chennakeshavadasa/PVT-Invariant-Ring-Amplifier/Design Files/README.md

RAMP.zip File contains all the schematics files involved in the design
