chennakeshavadasa/PVT-Invariant-Ring-Amplifier/Thesis/README.md

This work is primarily based on the PhD thesis 'Design Considerations and Circuit Techniques for Robust Ring-Amplifiers' by Praveen Kumar Venkatachala.
