chennakeshavadasa/PVT-Invariant-Ring-Amplifier/Design Files/RAMP/Fully-Diff-RAMP/RAMP-FD.png

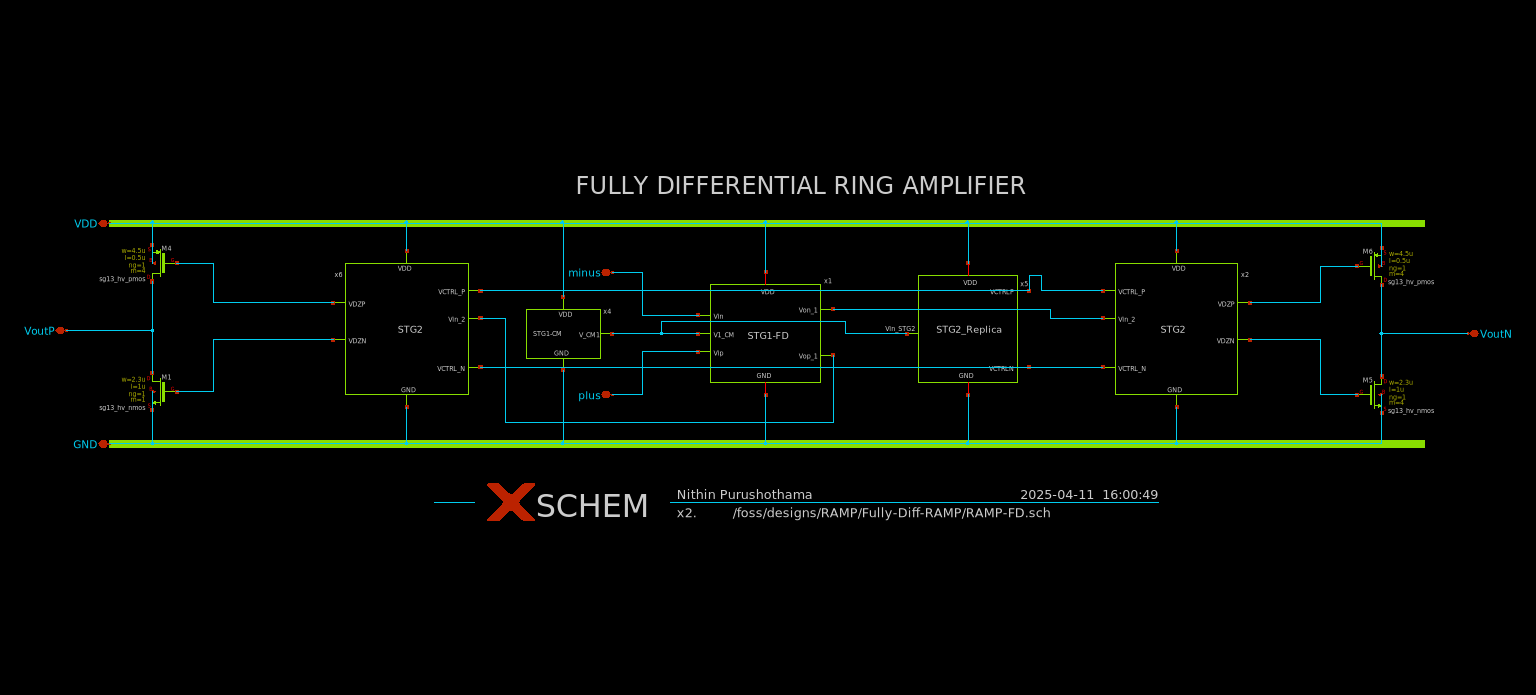
Design Files/RAMP/Fully-Diff-RAMP/RAMP-FD.png
