chennakeshavadasa/PVT-Invariant-Ring-Amplifier/Design Files/RAMP/Fully-Diff-RAMP/RAMP.png

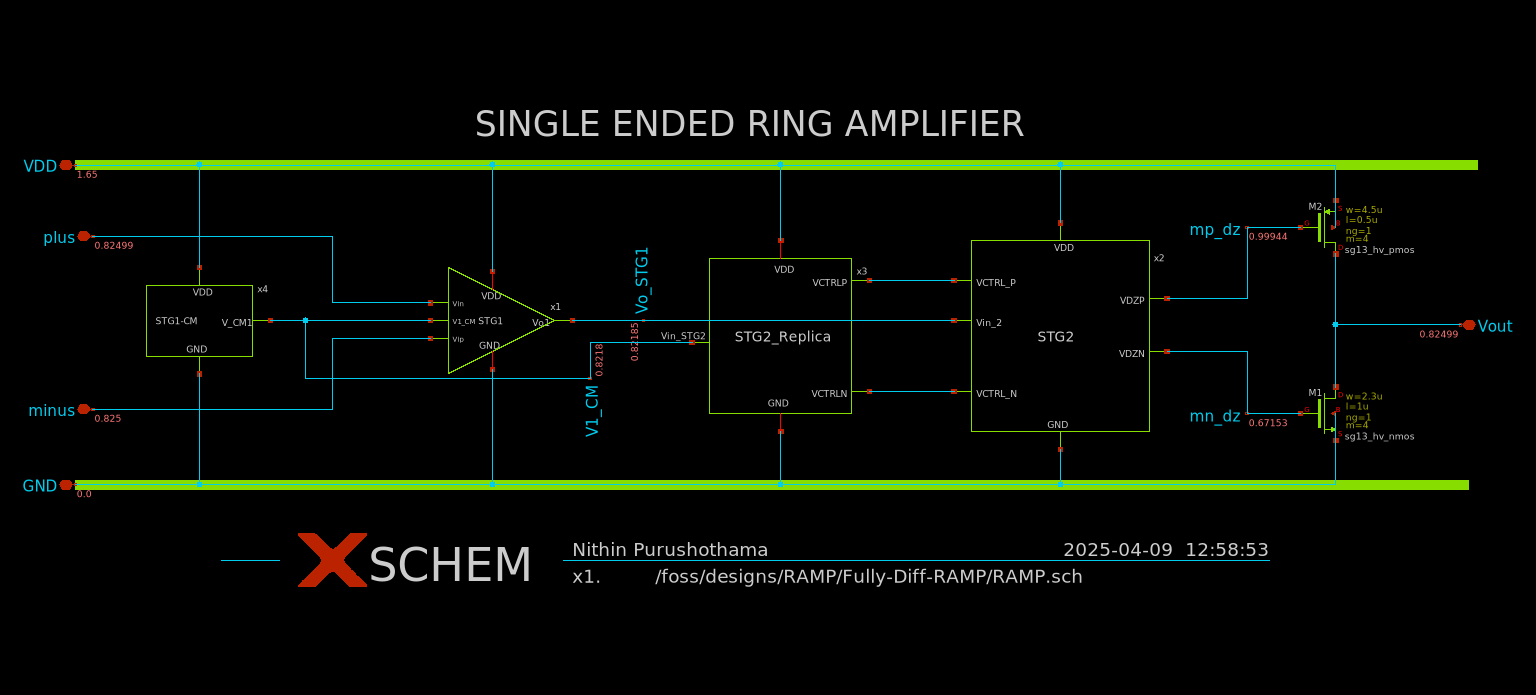
Design Files/RAMP/Fully-Diff-RAMP/RAMP.png
