chennakeshavadasa/PVT-Invariant-Ring-Amplifier/Design Files/RAMP/Fully-Diff-RAMP/STG1-CM.png

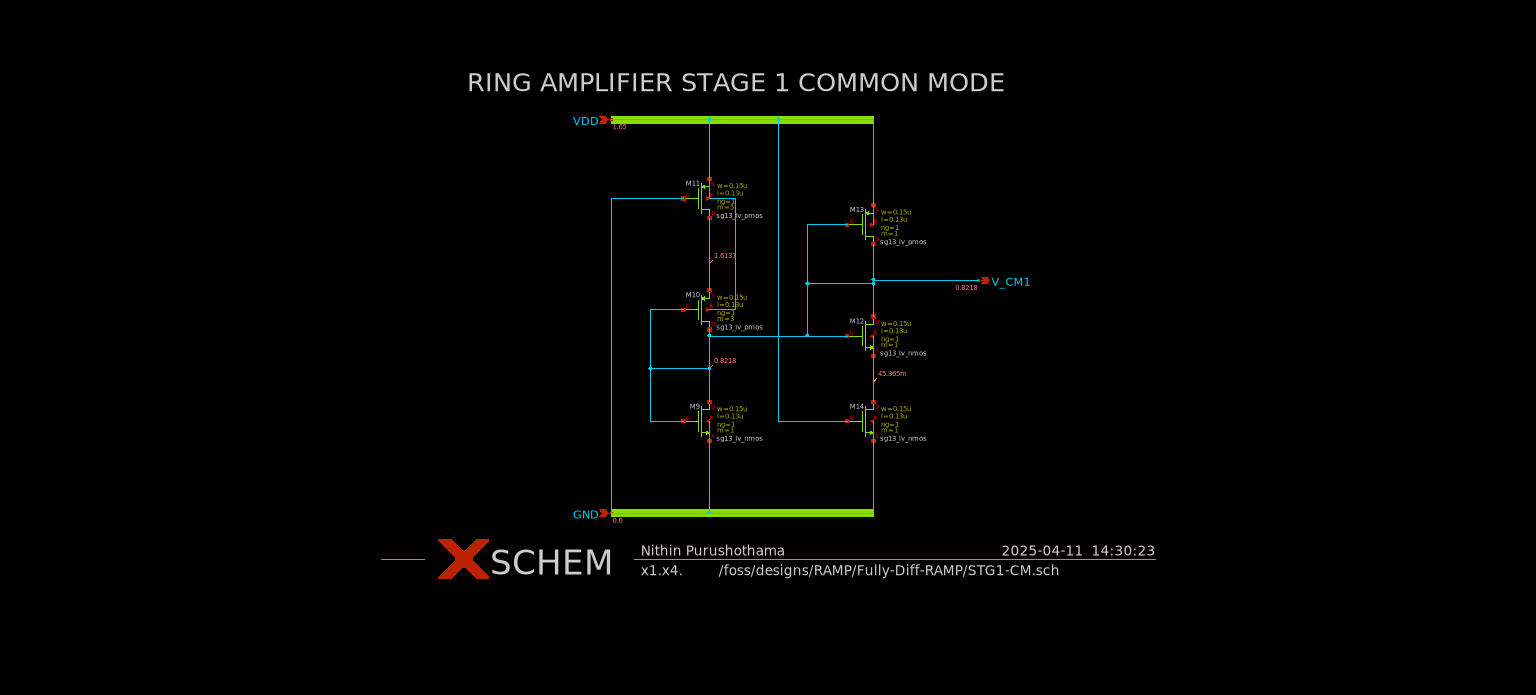
Design Files/RAMP/Fully-Diff-RAMP/STG1-CM.png
