chennakeshavadasa/PVT-Invariant-Ring-Amplifier/Design Files/RAMP/Fully-Diff-RAMP/STG1.png

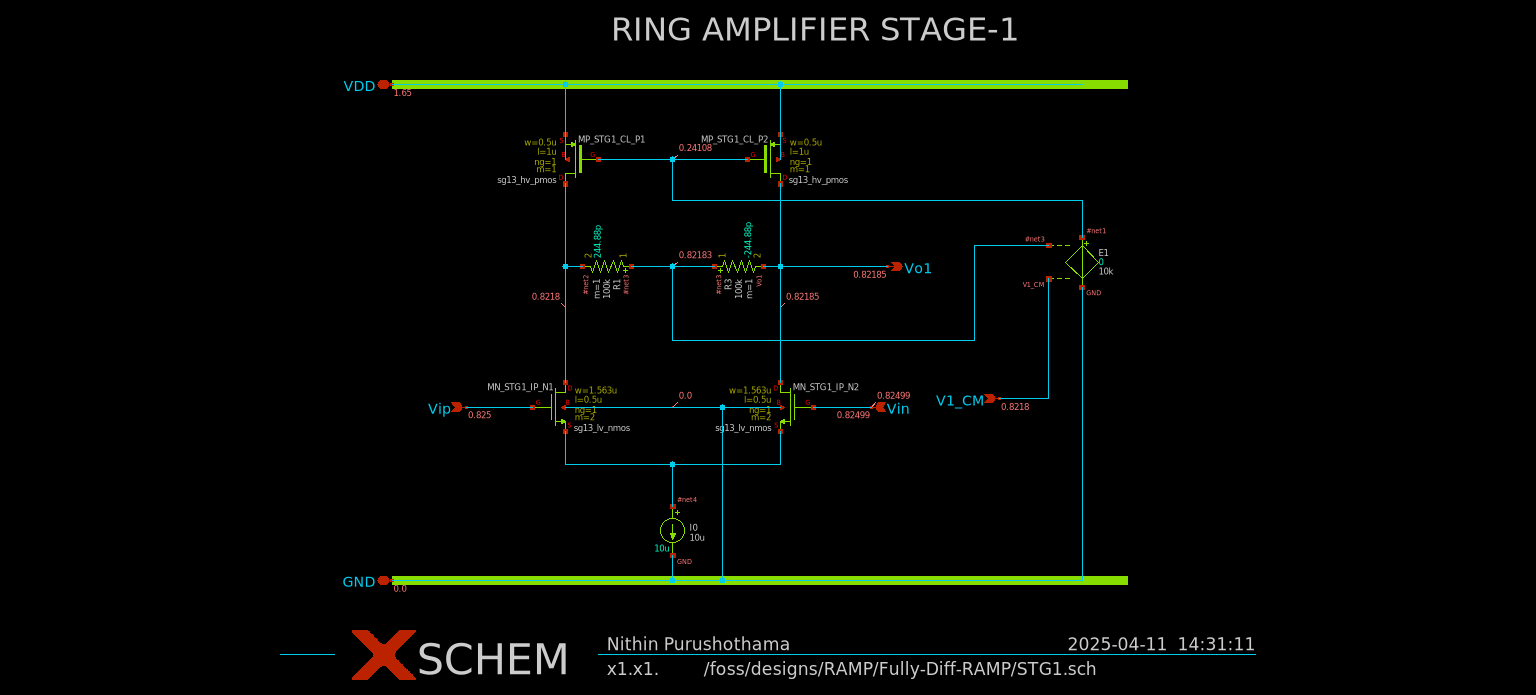
Design Files/RAMP/Fully-Diff-RAMP/STG1.png
