chennakeshavadasa/PVT-Invariant-Ring-Amplifier/Design Files/RAMP/Fully-Diff-RAMP/STG2.png

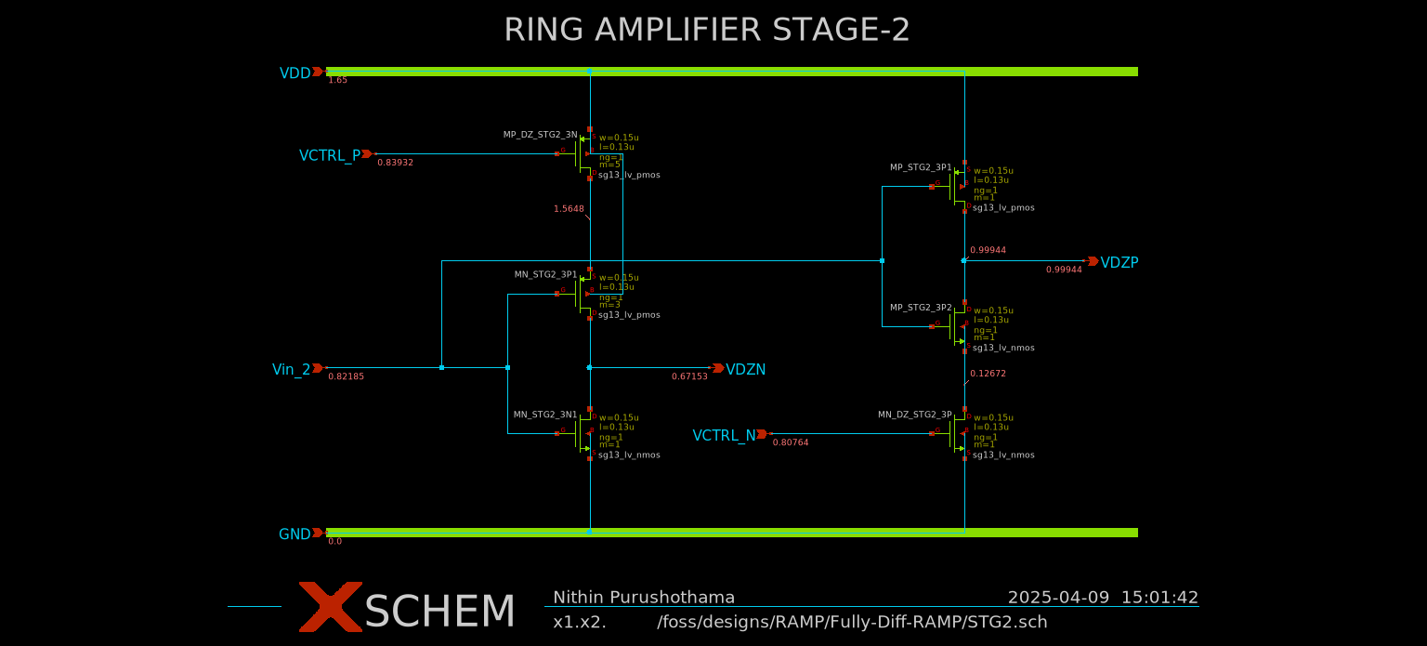
Design Files/RAMP/Fully-Diff-RAMP/STG2.png
