chennakeshavadasa/PVT-Invariant-Ring-Amplifier/Design Files/RAMP/Fully-Diff-RAMP/STG2_Replica.png

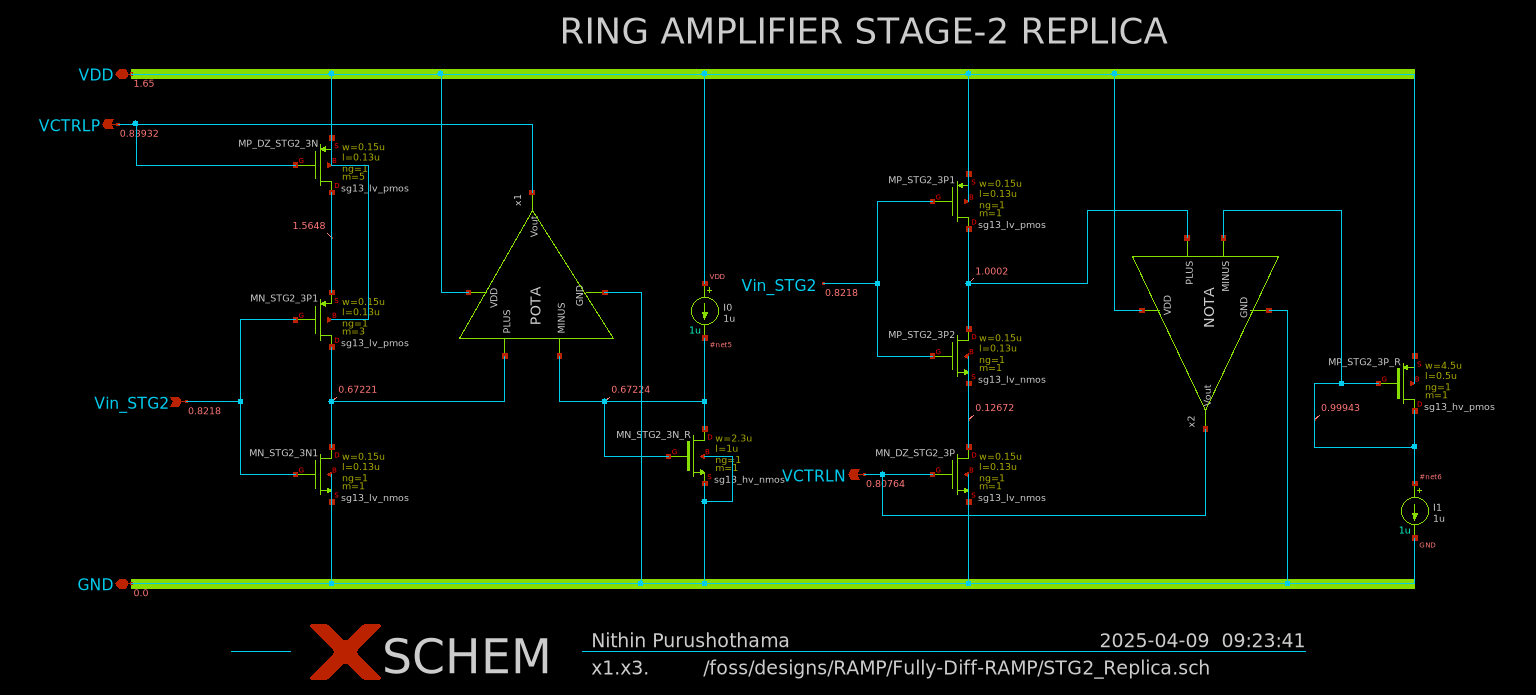
Design Files/RAMP/Fully-Diff-RAMP/STG2_Replica.png
