chennakeshavadasa/PVT-Invariant-Ring-Amplifier/Design Files/RAMP/STG2/DZD_Trk_STG2_try1.png

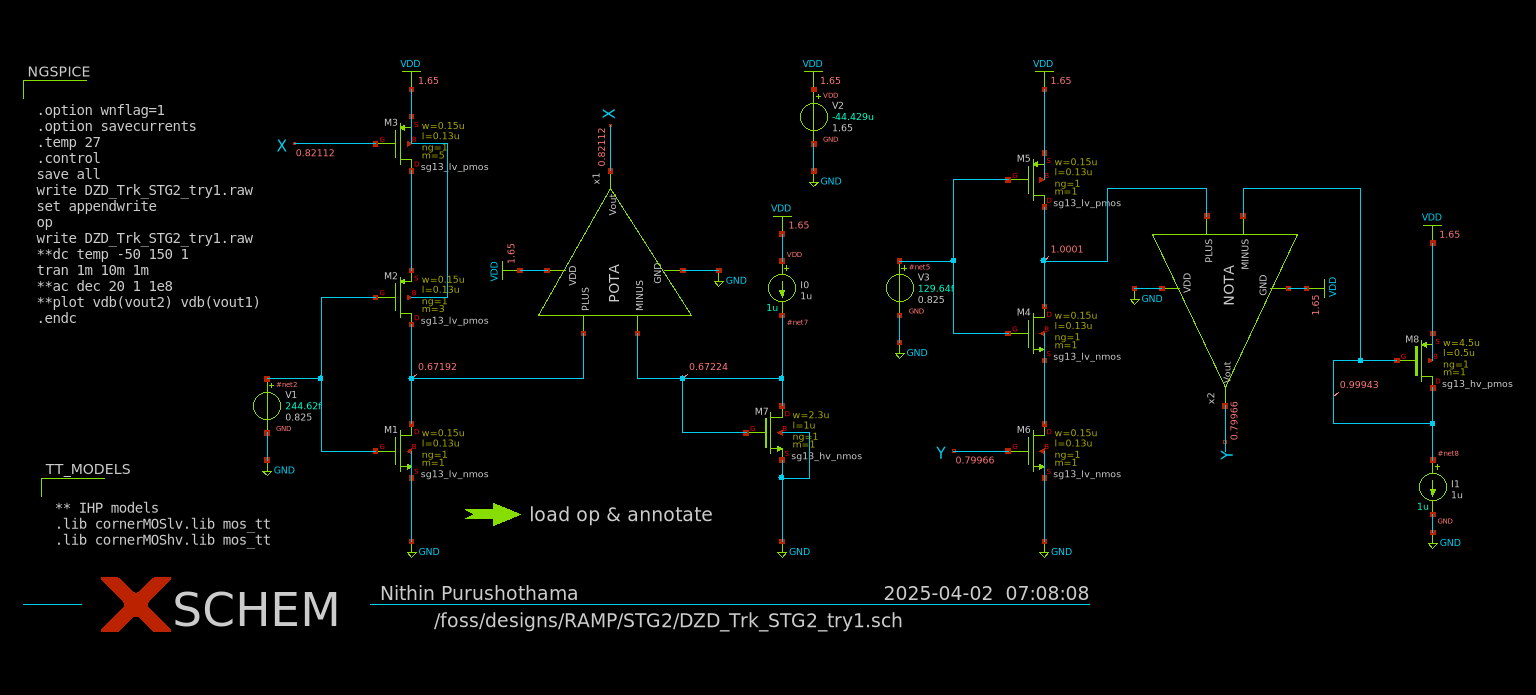
Design Files/RAMP/STG2/DZD_Trk_STG2_try1.png
