chennakeshavadasa/PVT-Invariant-Ring-Amplifier/docs/figures/composites/fig_hero.png

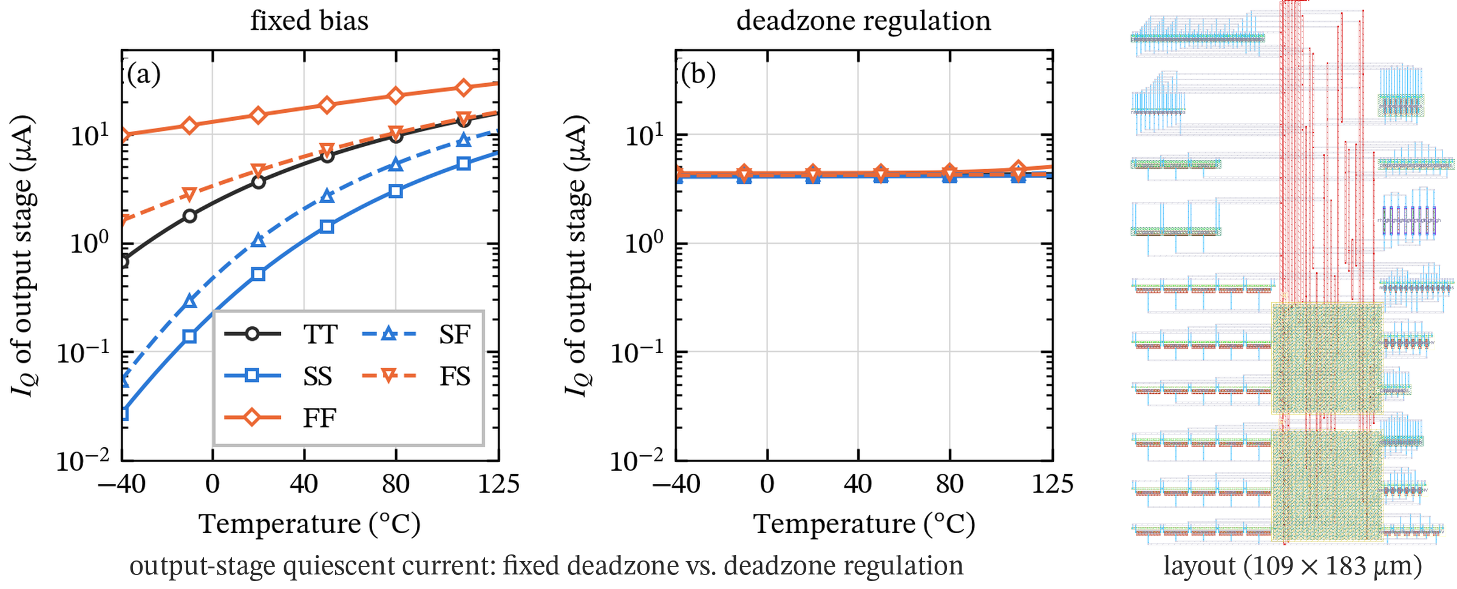
docs/figures/composites/fig_hero.png
