chennakeshavadasa/PVT-Invariant-Ring-Amplifier/docs/figures/diagrams/fig_architecture_v2.png

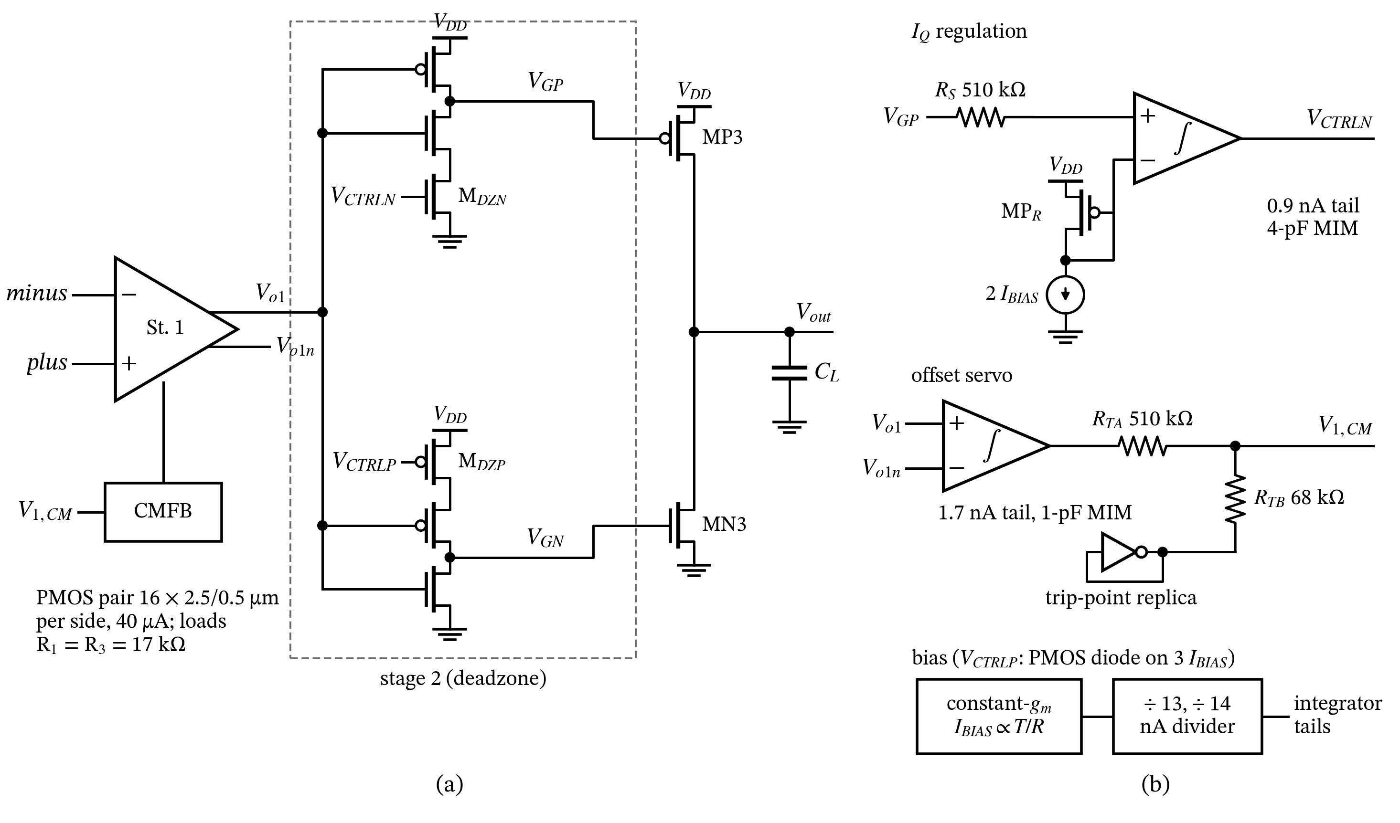
docs/figures/diagrams/fig_architecture_v2.png
