chennakeshavadasa/PVT-Invariant-Ring-Amplifier/docs/figures/layout/fig_layout_plain.png

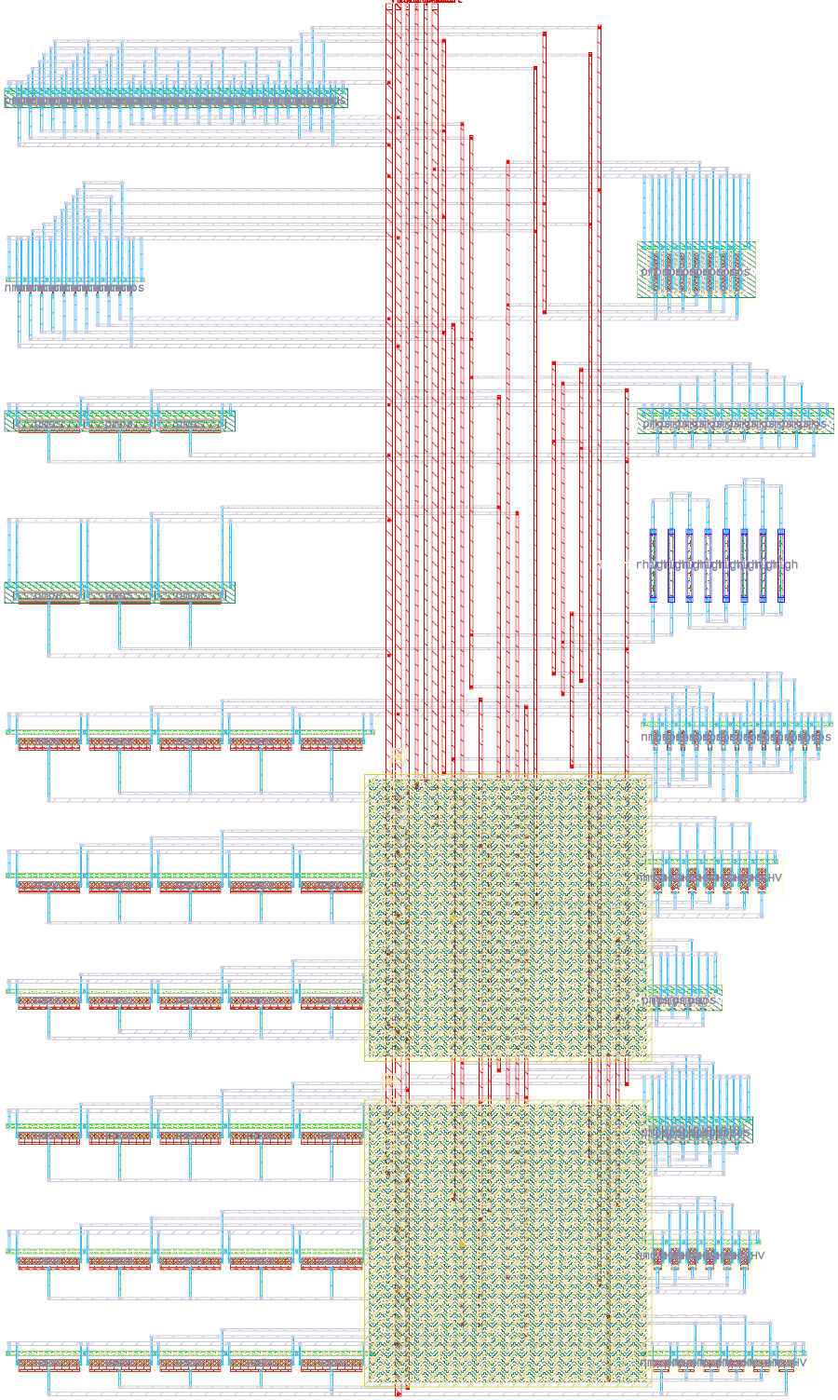
docs/figures/layout/fig_layout_plain.png
