chennakeshavadasa/PVT-Invariant-Ring-Amplifier/docs/figures/layout/fig_layout_v2_full.png

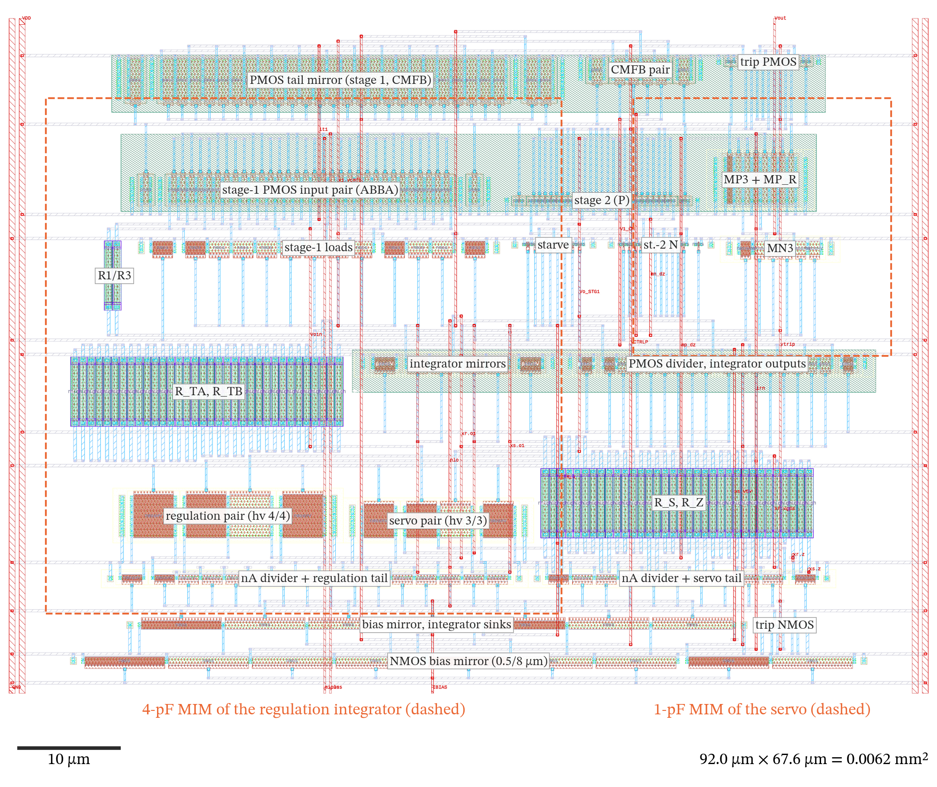
docs/figures/layout/fig_layout_v2_full.png
