chennakeshavadasa/PVT-Invariant-Ring-Amplifier/docs/figures/layout/fig_layout_v2_matching.png

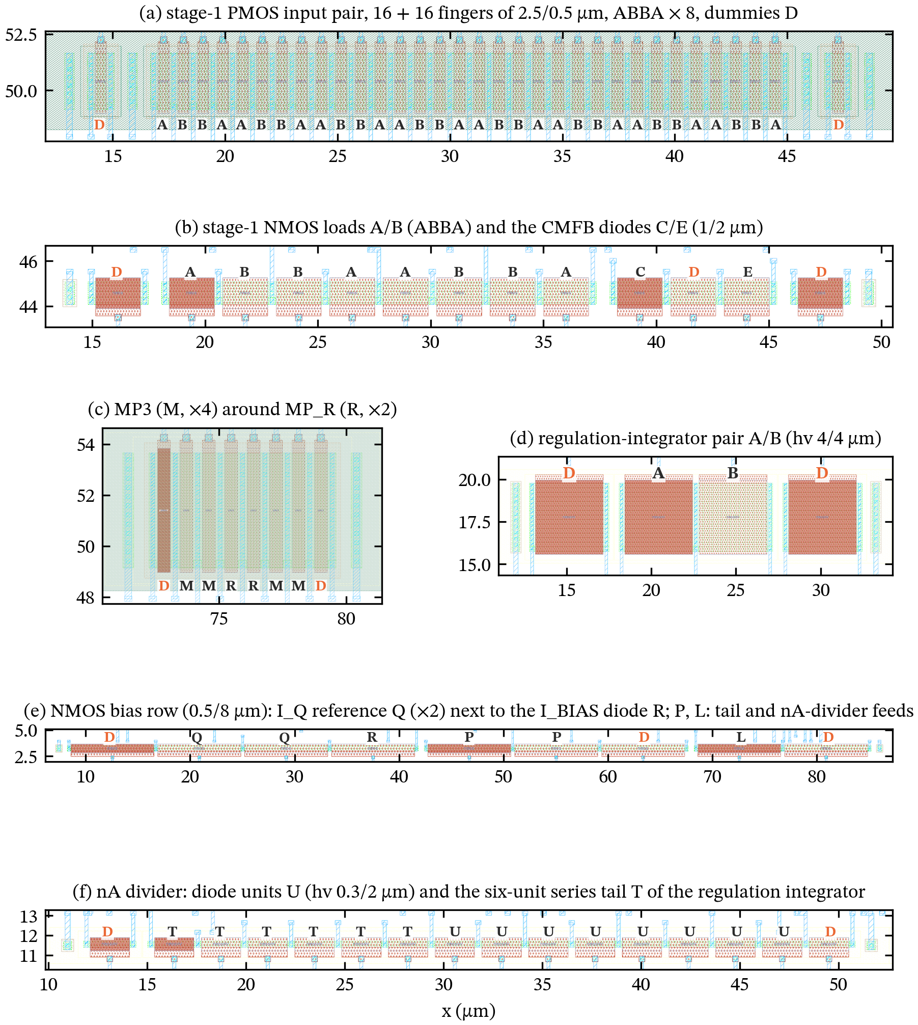
docs/figures/layout/fig_layout_v2_matching.png
