chennakeshavadasa/PVT-Invariant-Ring-Amplifier/docs/figures/schematics/sch_pota.png

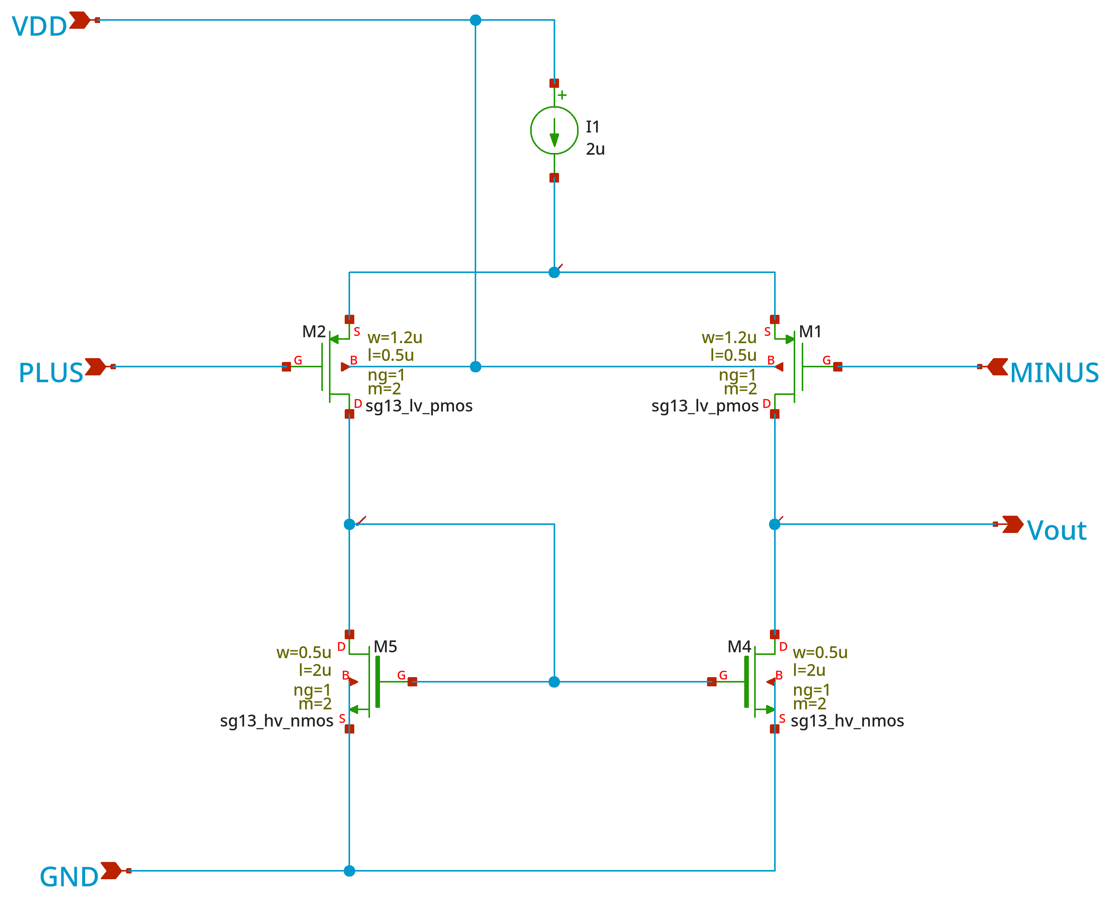
docs/figures/schematics/sch_pota.png
