chennakeshavadasa/PVT-Invariant-Ring-Amplifier/docs/figures/schematics/sch_stg1.png

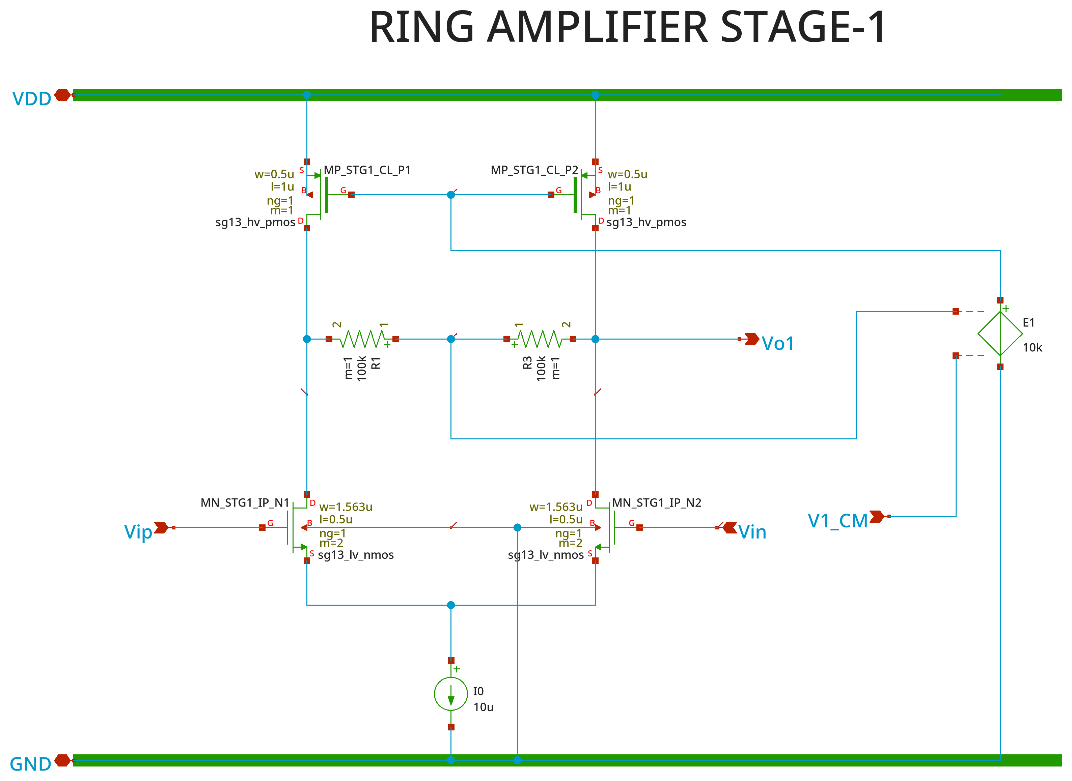
docs/figures/schematics/sch_stg1.png
