chennakeshavadasa/PVT-Invariant-Ring-Amplifier/docs/figures/schematics/sch_stg2.png

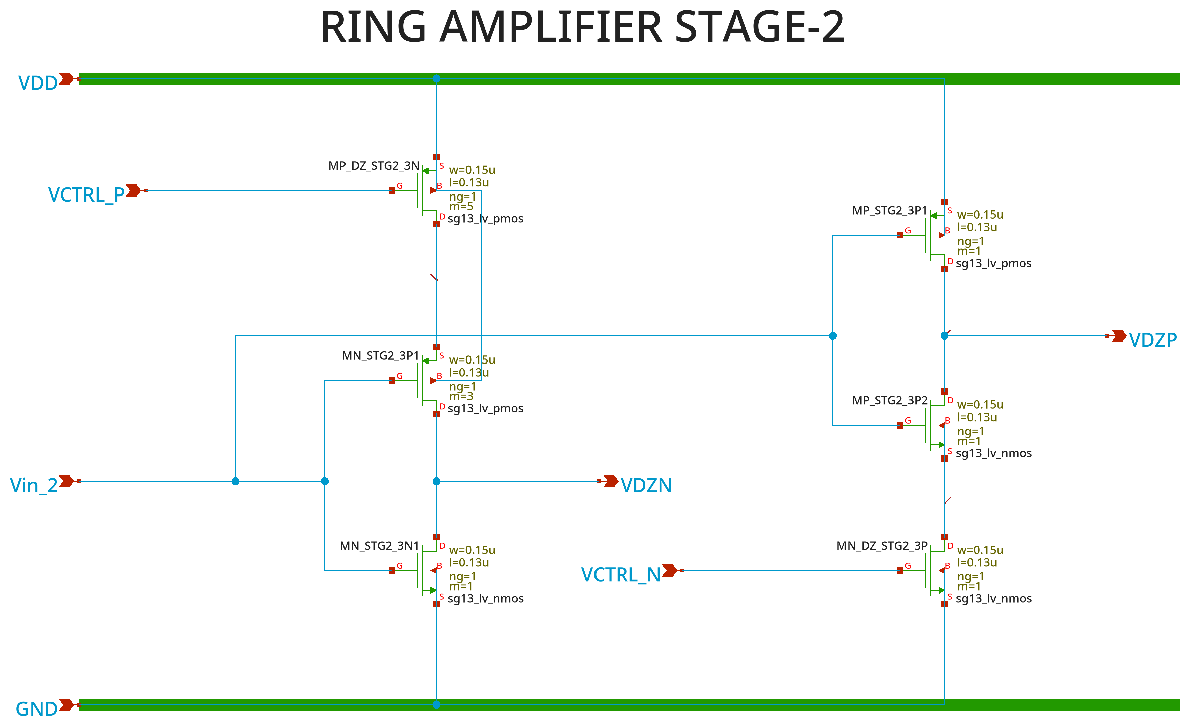
docs/figures/schematics/sch_stg2.png
