chennakeshavadasa/PVT-Invariant-Ring-Amplifier/docs/figures/schematics/sch_stg2_replica.png

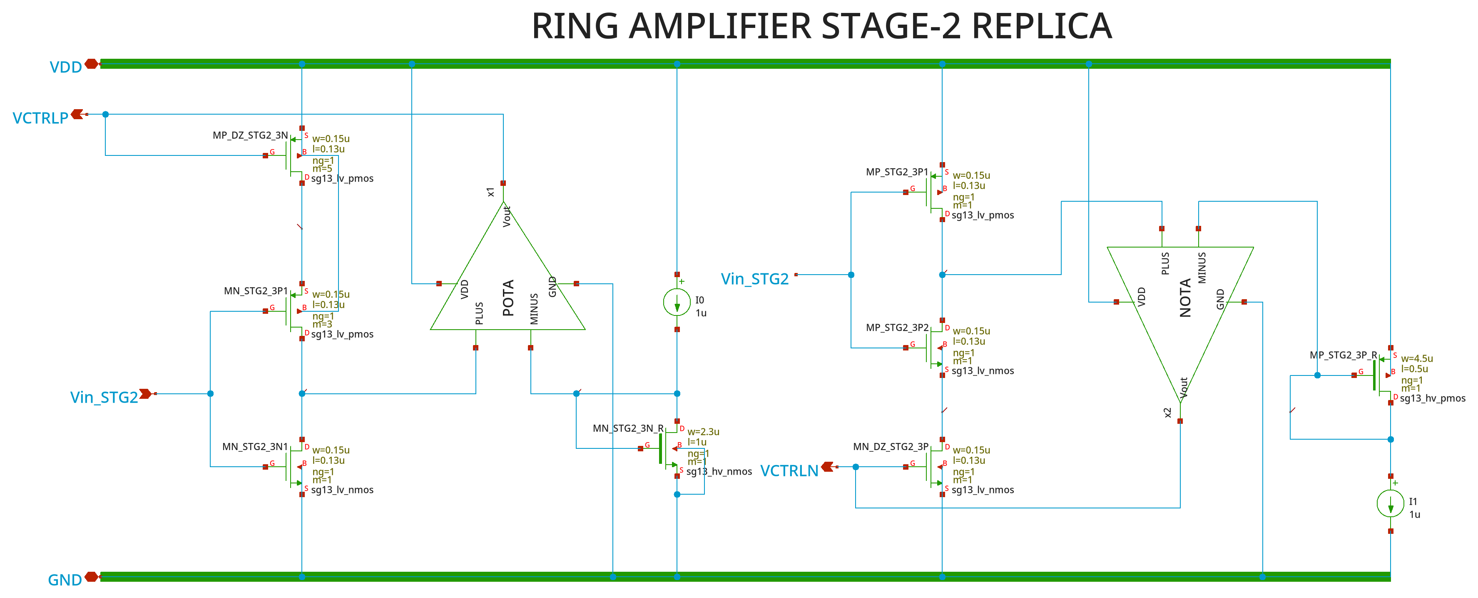
docs/figures/schematics/sch_stg2_replica.png
