chennakeshavadasa/PVT-Invariant-Ring-Amplifier/docs/figures/thesis/fig2_1_sc_amplifier.png

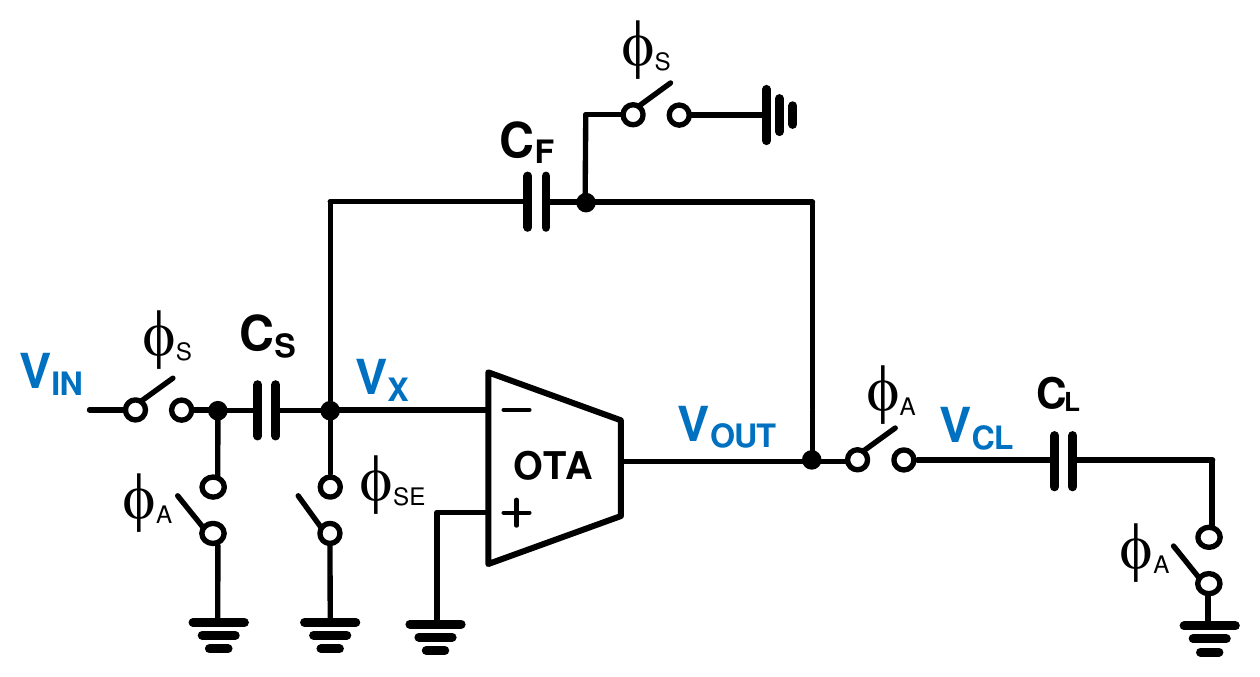
docs/figures/thesis/fig2_1_sc_amplifier.png
