chennakeshavadasa/PVT-Invariant-Ring-Amplifier/docs/figures/thesis/fig2_10_ringamp_iv.png

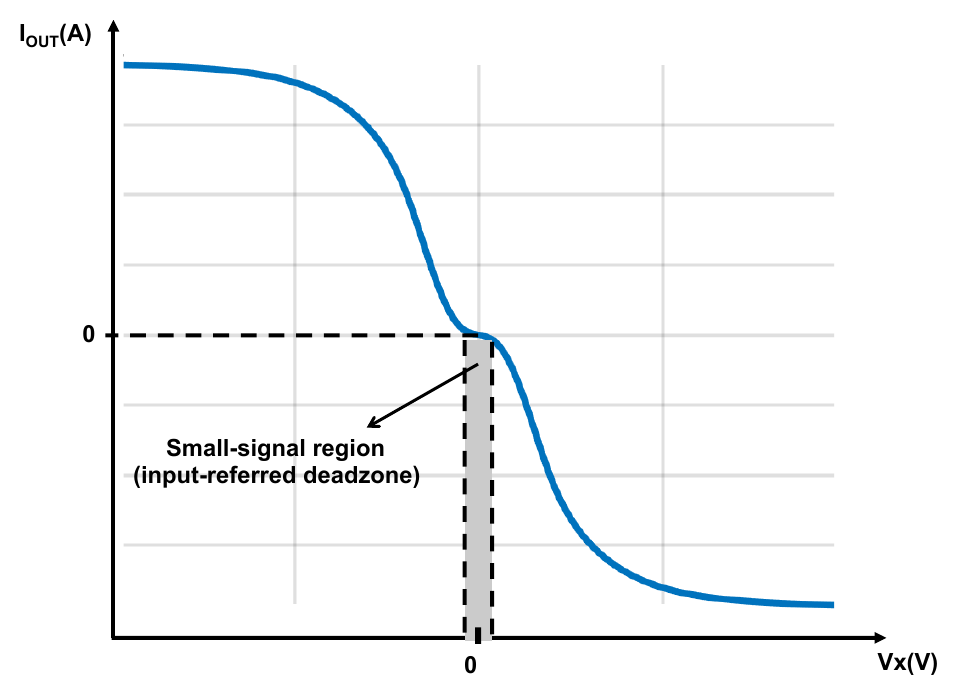
docs/figures/thesis/fig2_10_ringamp_iv.png
