chennakeshavadasa/PVT-Invariant-Ring-Amplifier/docs/figures/thesis/fig2_13_ringamp_overshoot.png

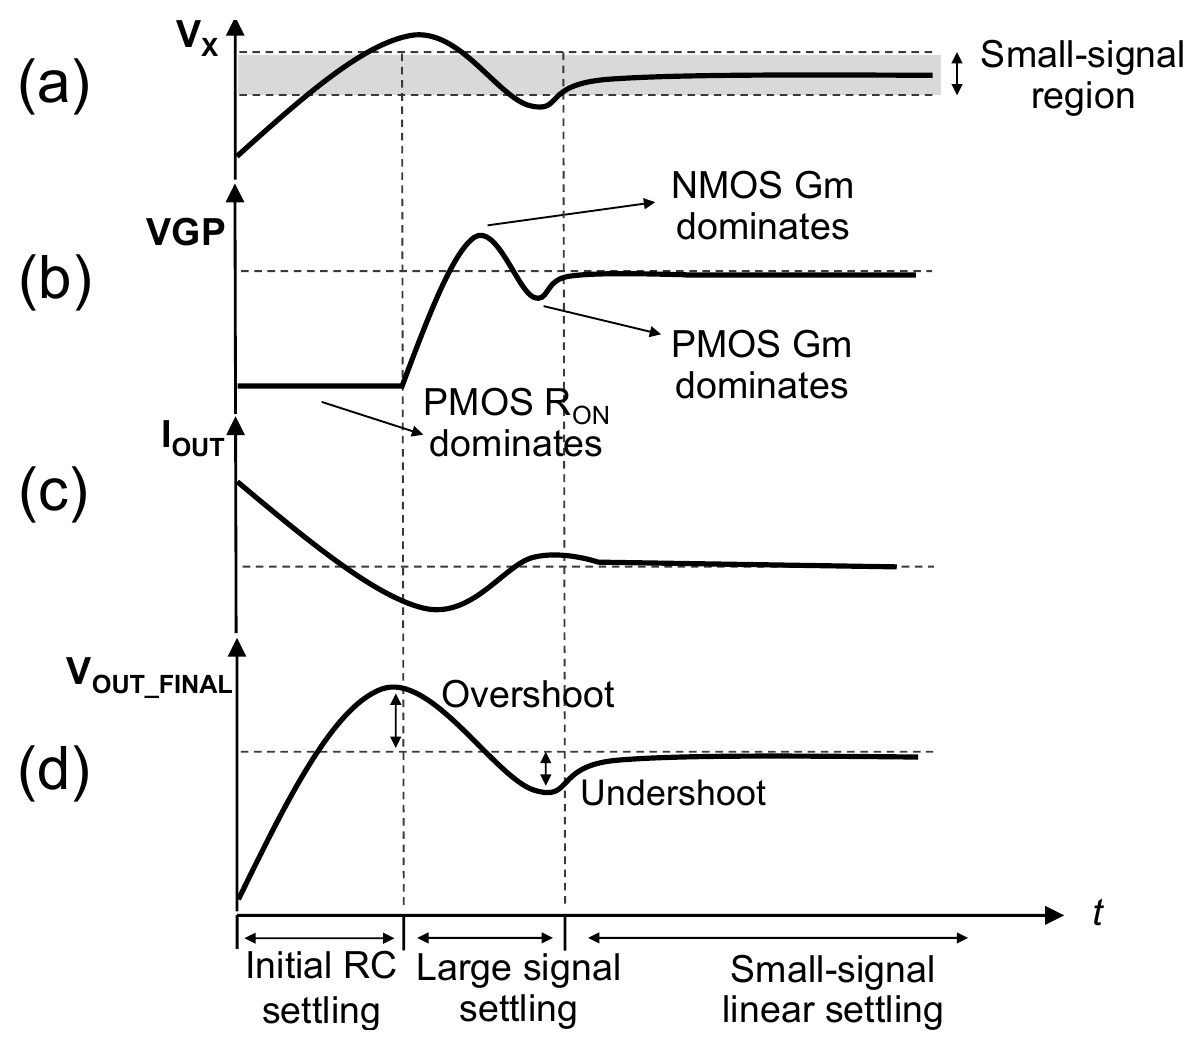
docs/figures/thesis/fig2_13_ringamp_overshoot.png
