chennakeshavadasa/PVT-Invariant-Ring-Amplifier/docs/figures/thesis/fig2_19_rc_model.png

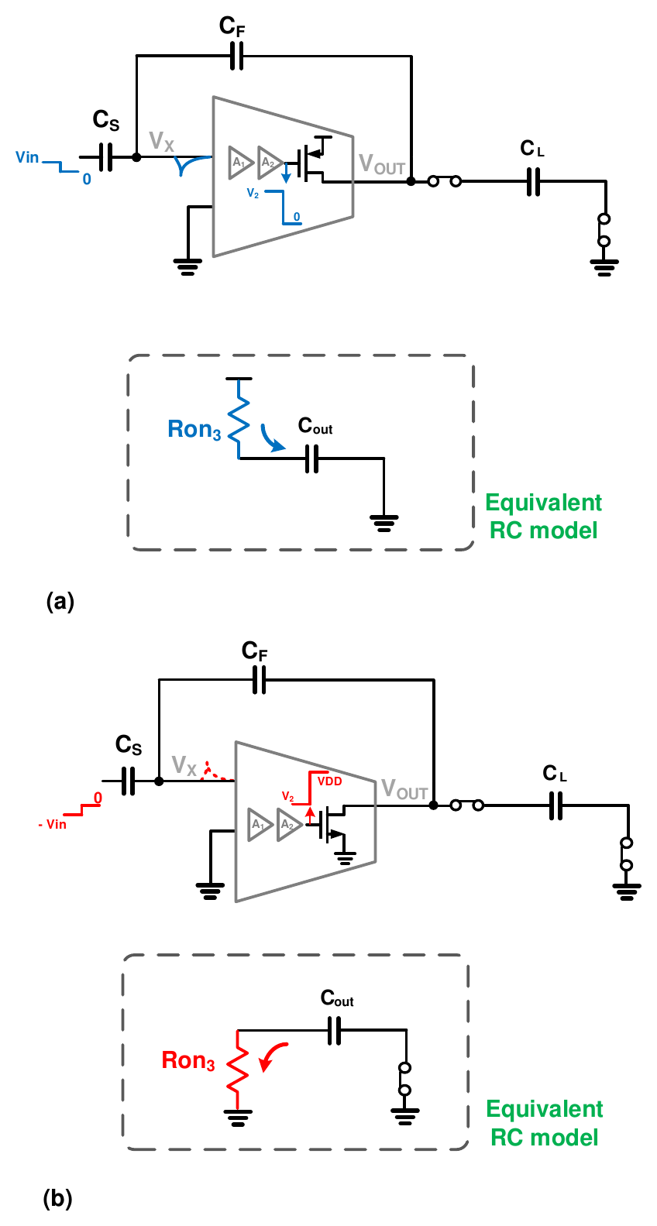
docs/figures/thesis/fig2_19_rc_model.png
