chennakeshavadasa/PVT-Invariant-Ring-Amplifier/docs/figures/thesis/fig2_21_current_starved_ringamp.png

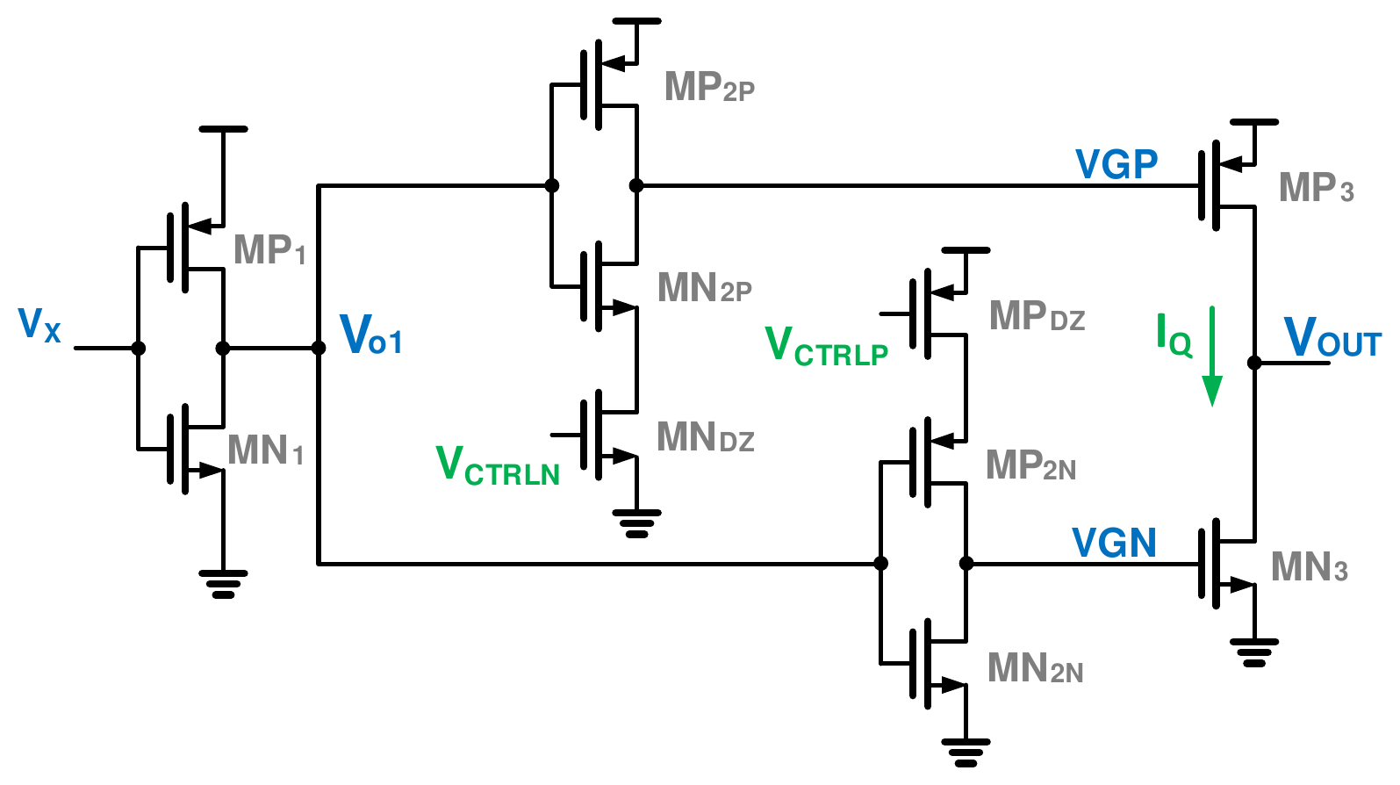
docs/figures/thesis/fig2_21_current_starved_ringamp.png
