chennakeshavadasa/PVT-Invariant-Ring-Amplifier/docs/figures/thesis/fig2_22_settling_example.png

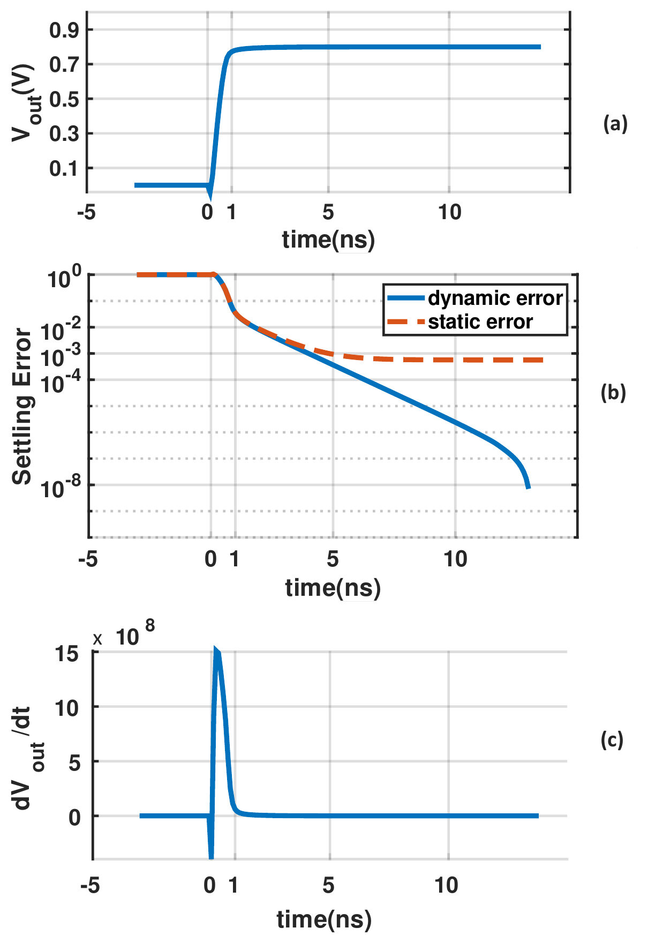
docs/figures/thesis/fig2_22_settling_example.png
