chennakeshavadasa/PVT-Invariant-Ring-Amplifier/docs/figures/thesis/fig3_2_resistor_deadzone.png

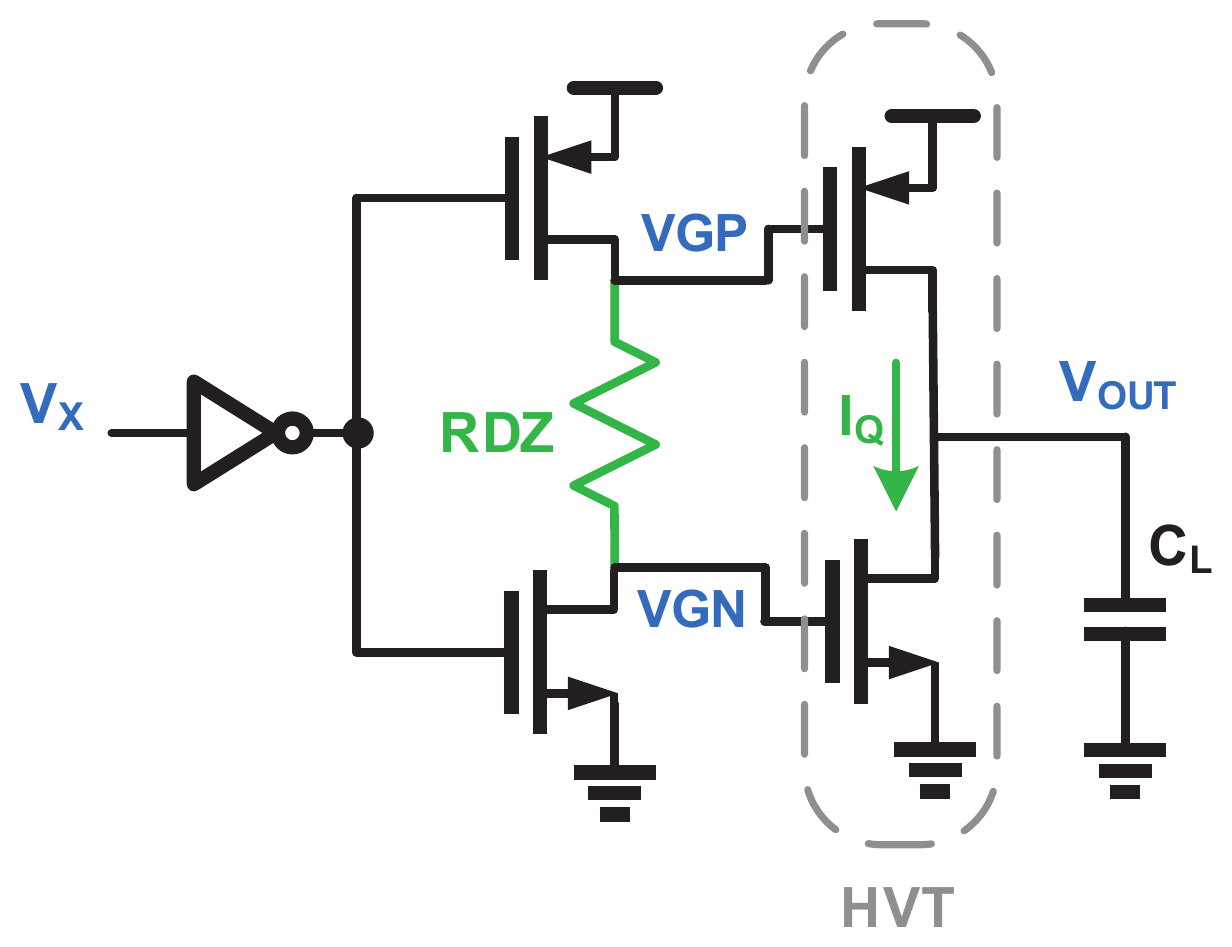
docs/figures/thesis/fig3_2_resistor_deadzone.png
