chennakeshavadasa/PVT-Invariant-Ring-Amplifier/docs/figures/v2/fig_v2_bode_corners.png

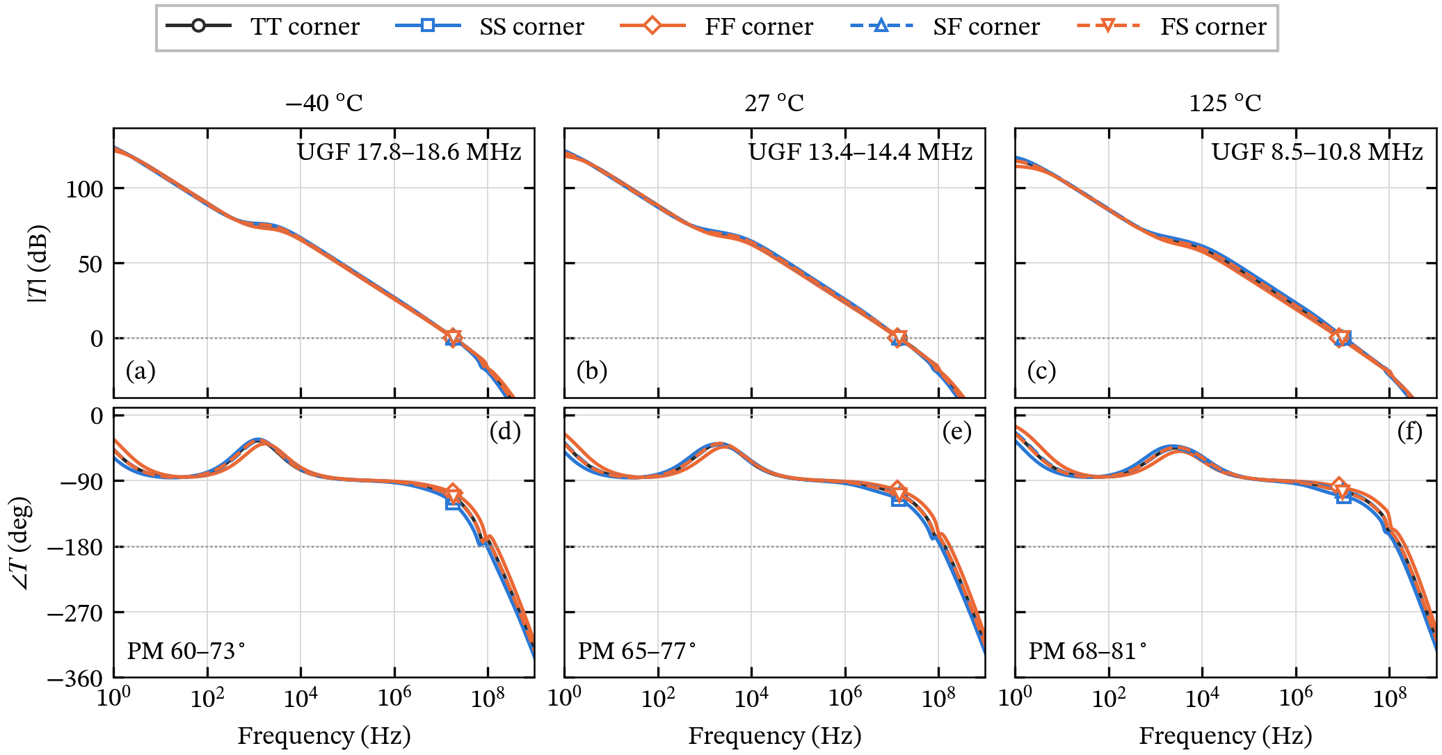
docs/figures/v2/fig_v2_bode_corners.png
