chennakeshavadasa/PVT-Invariant-Ring-Amplifier/docs/figures/v2/fig_v2_iq_temperature.png

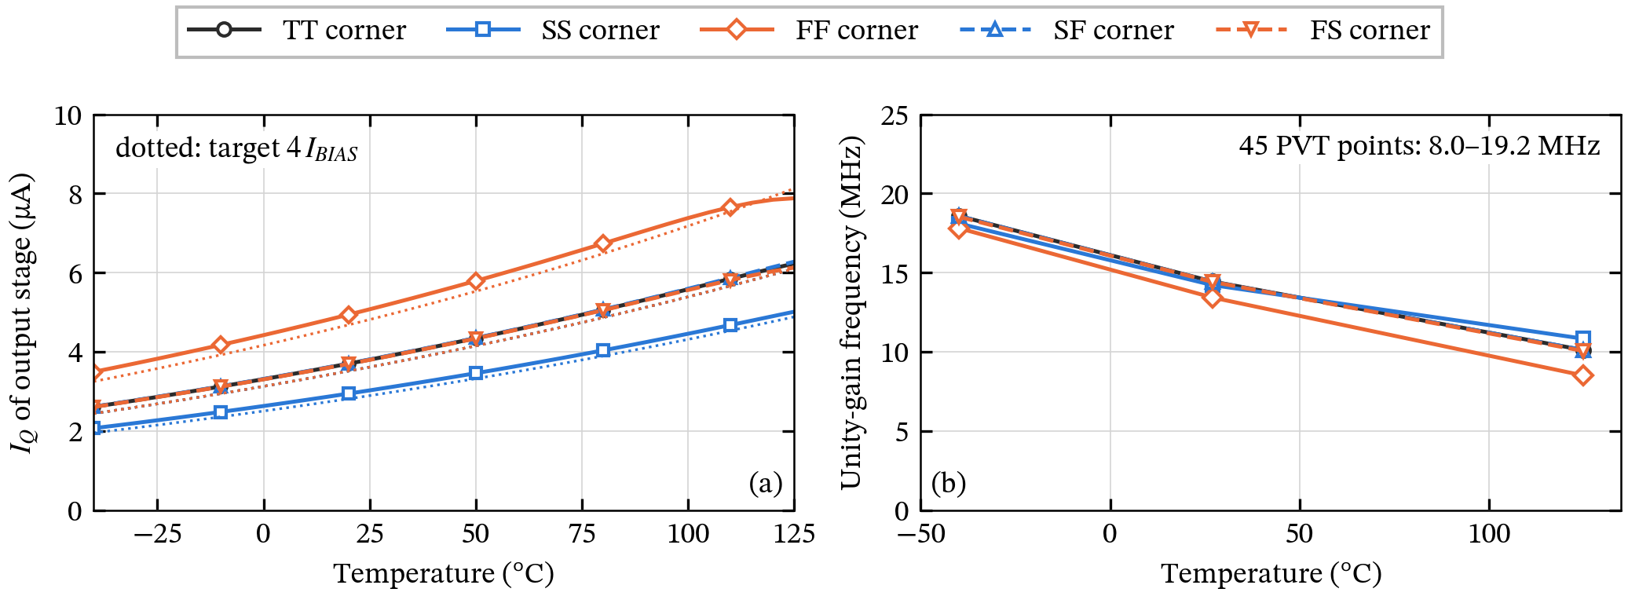
docs/figures/v2/fig_v2_iq_temperature.png
