chennakeshavadasa/PVT-Invariant-Ring-Amplifier/docs/figures/v2/fig_v2_limit_cycle.png

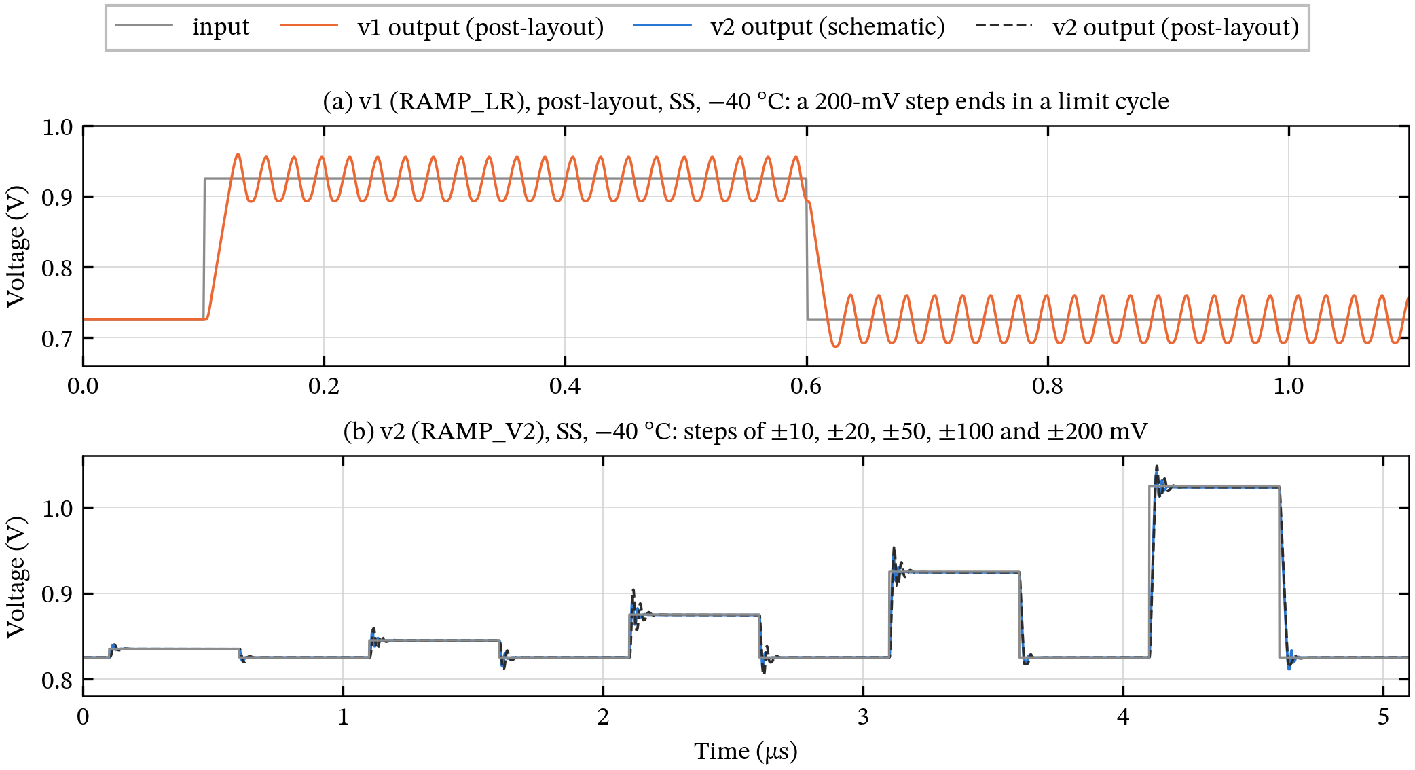
docs/figures/v2/fig_v2_limit_cycle.png
