chennakeshavadasa/PVT-Invariant-Ring-Amplifier/docs/figures/v2/fig_v2_mc_offset_iq.png

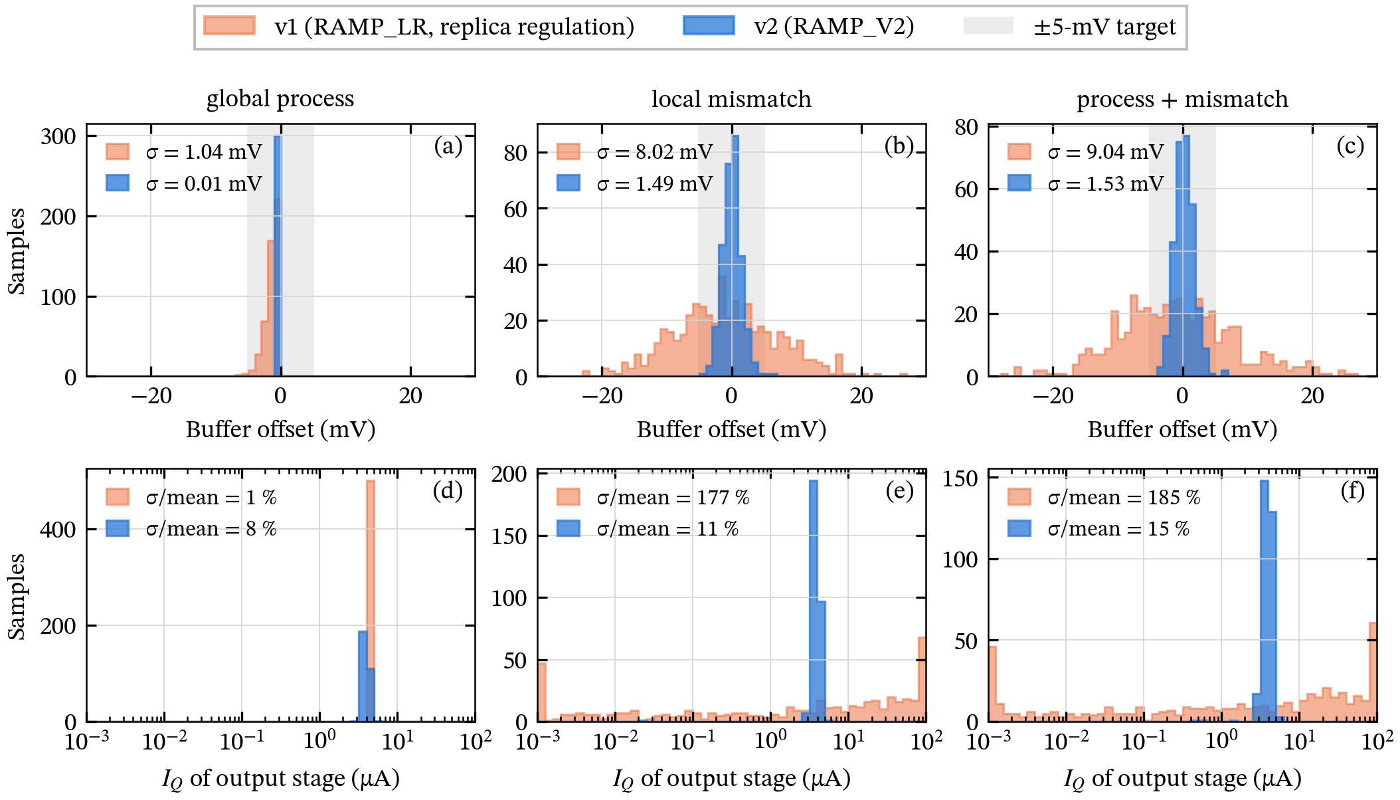
docs/figures/v2/fig_v2_mc_offset_iq.png
