chennakeshavadasa/PVT-Invariant-Ring-Amplifier/docs/figures/v2/fig_v2_mc_perf.png

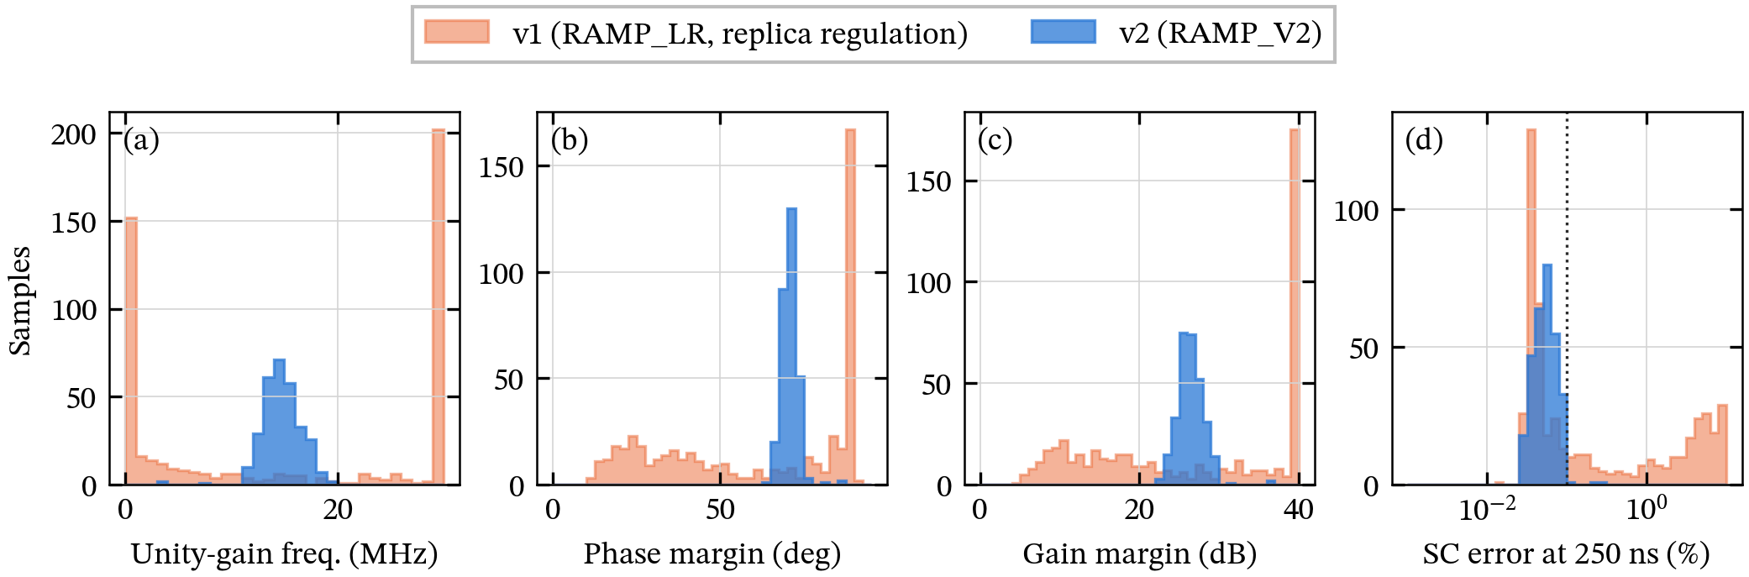
docs/figures/v2/fig_v2_mc_perf.png
