chennakeshavadasa/PVT-Invariant-Ring-Amplifier/docs/figures/v2/fig_v2_mc_waves.png

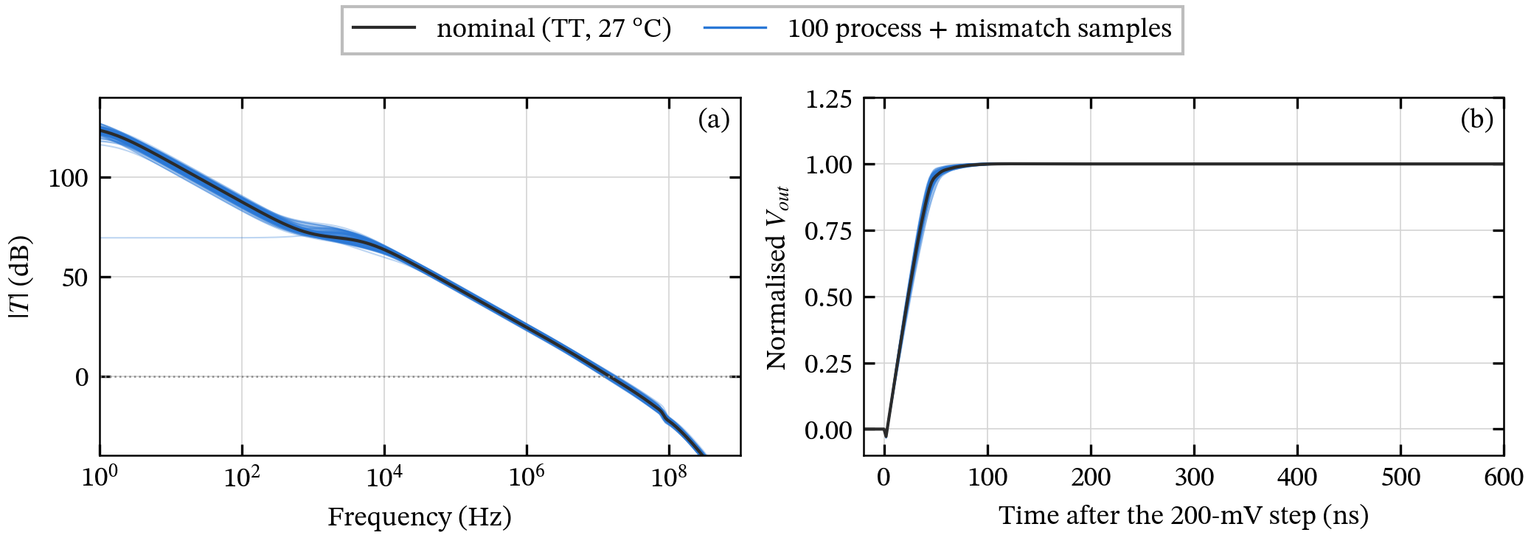
docs/figures/v2/fig_v2_mc_waves.png
