chennakeshavadasa/PVT-Invariant-Ring-Amplifier/docs/figures/v2/fig_v2_power.png

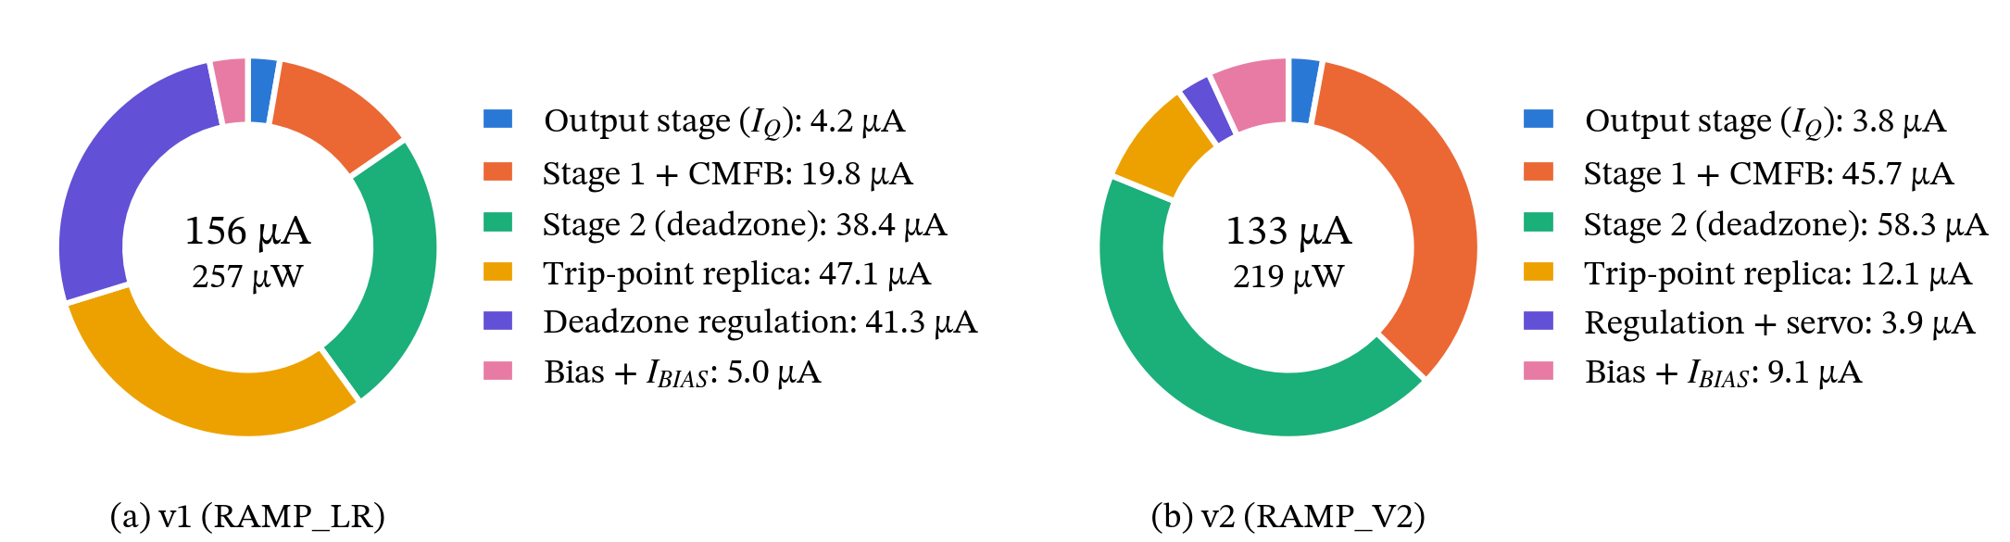
docs/figures/v2/fig_v2_power.png
