chennakeshavadasa/PVT-Invariant-Ring-Amplifier/docs/figures/v2/fig_v2_pvt_ugf_pm.png

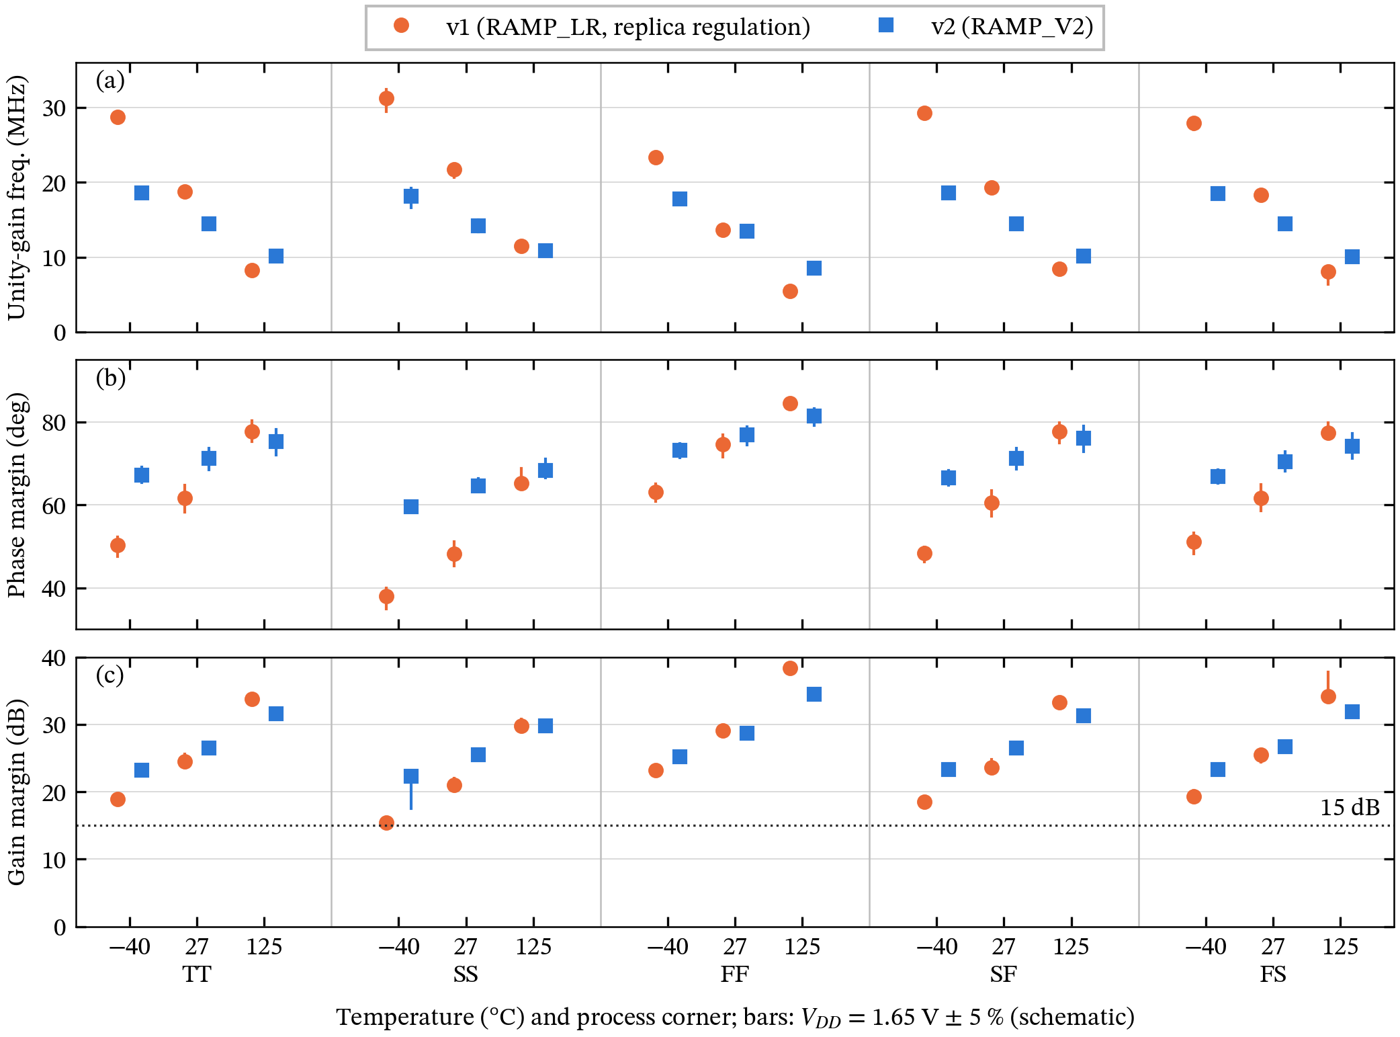
docs/figures/v2/fig_v2_pvt_ugf_pm.png
