chennakeshavadasa/PVT-Invariant-Ring-Amplifier/docs/figures/v2/fig_v2_settling_pvt.png

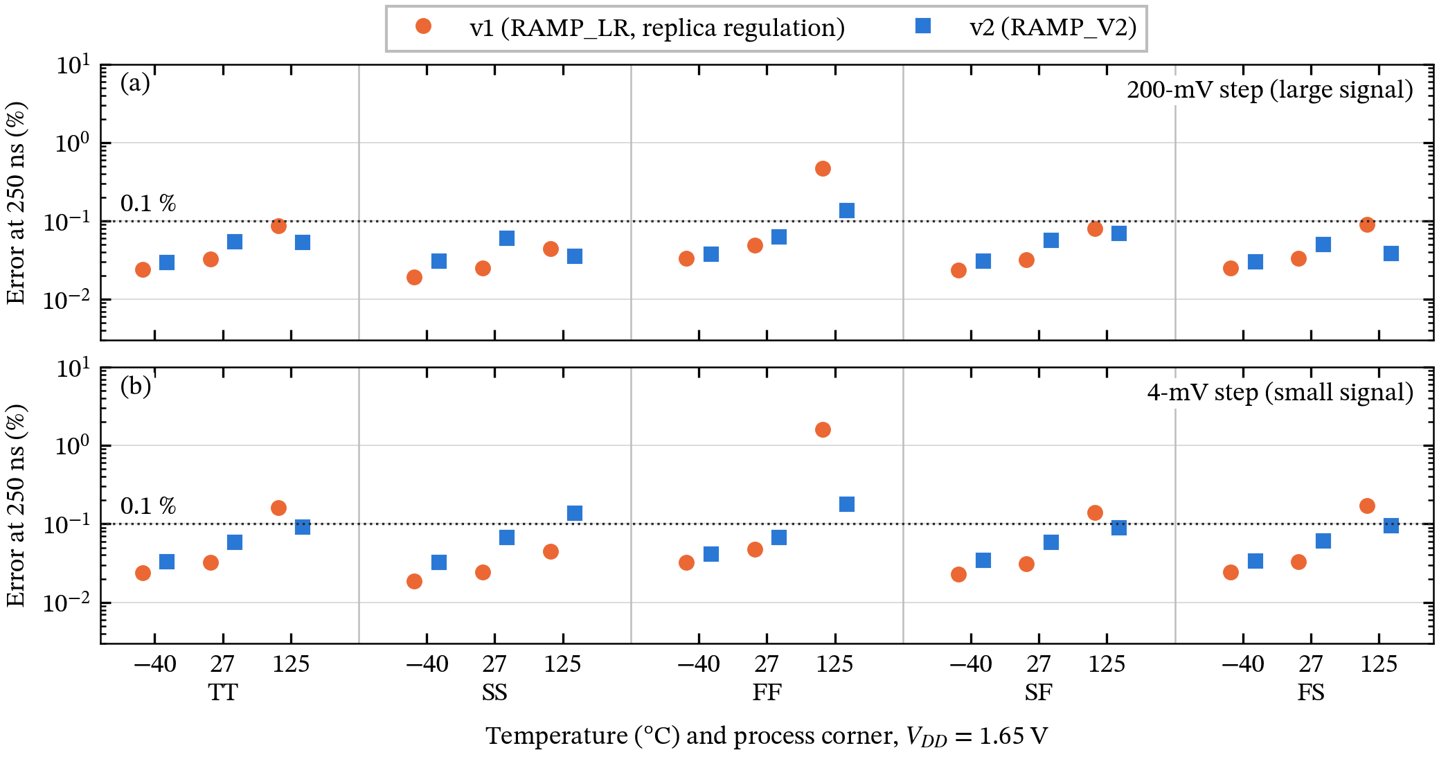
docs/figures/v2/fig_v2_settling_pvt.png
