chennakeshavadasa/PVT-Invariant-Ring-Amplifier/docs/figures/v2/fig_v2_startup.png

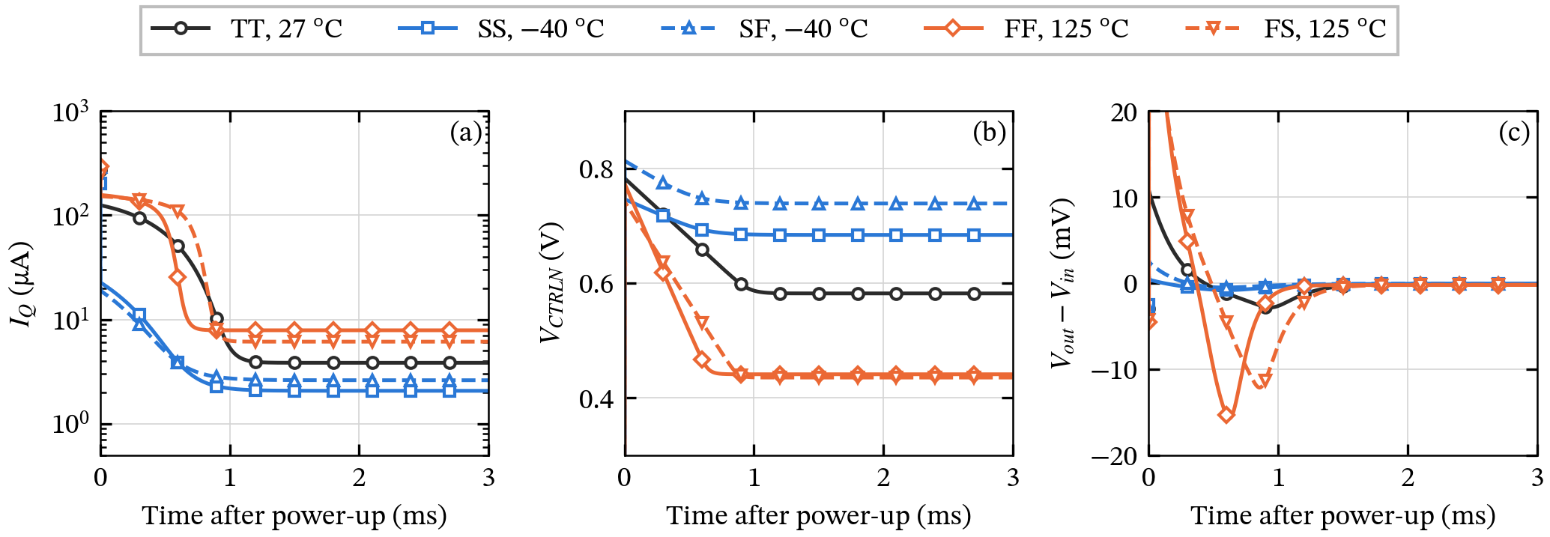
docs/figures/v2/fig_v2_startup.png
