chennakeshavadasa/PVT-Invariant-Ring-Amplifier/docs/figures/v2/fig_v2_tail_study.png

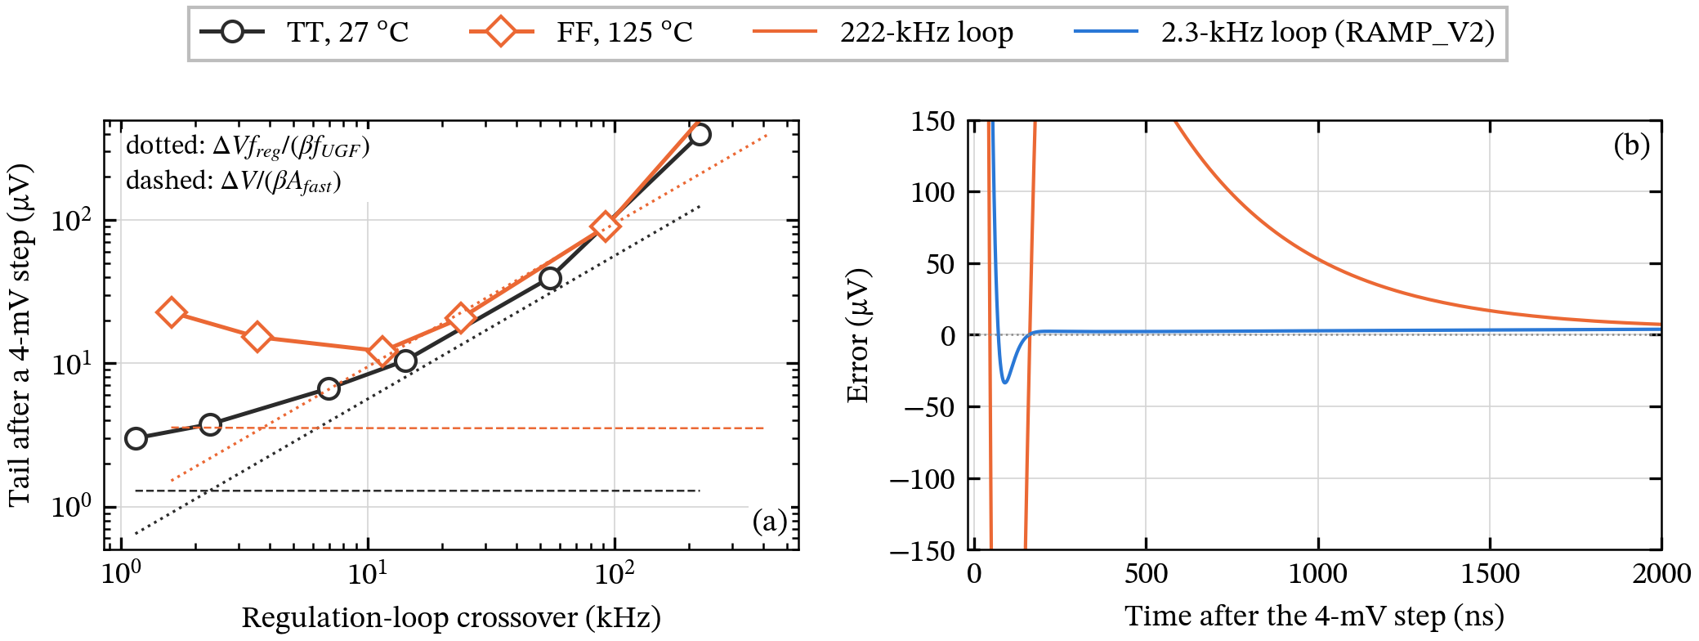
docs/figures/v2/fig_v2_tail_study.png
