chennakeshavadasa/PVT-Invariant-Ring-Amplifier/docs/figures/thesis/fig3_4_sc_setup.png

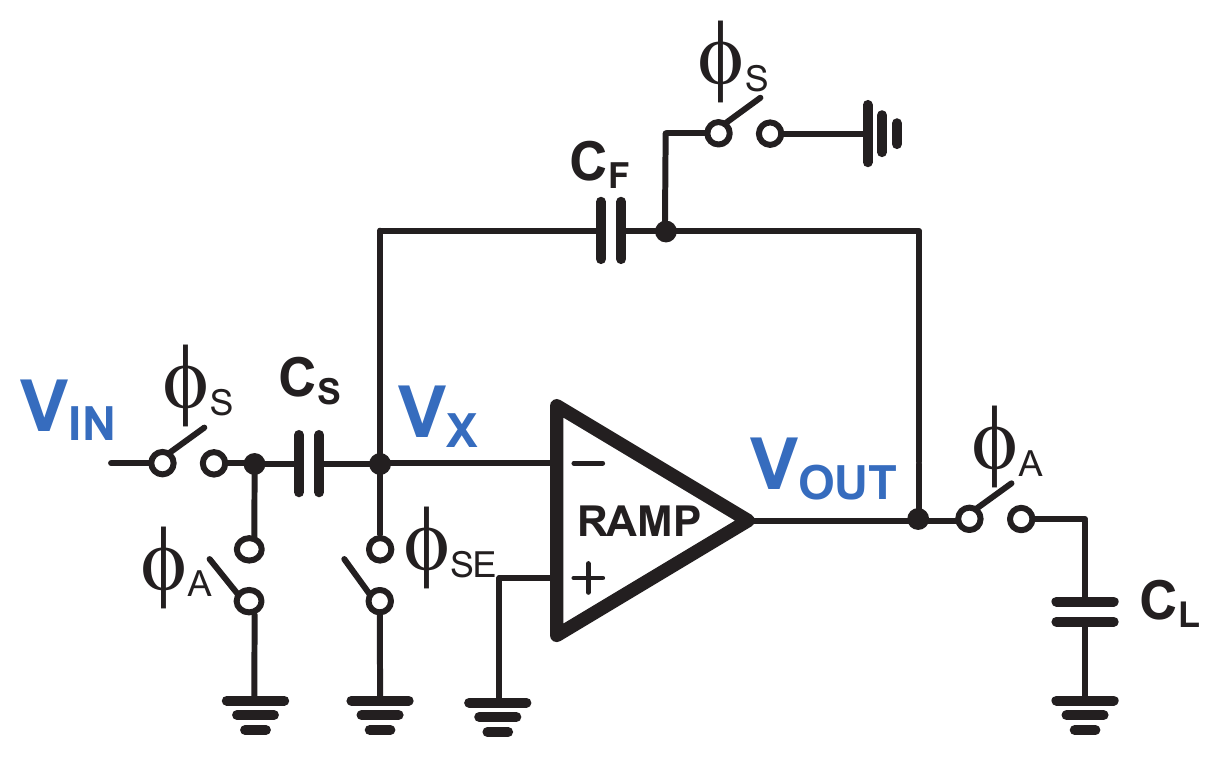
docs/figures/thesis/fig3_4_sc_setup.png
