chennakeshavadasa/PVT-Invariant-Ring-Amplifier/docs/figures/v2/fig_v2_postlayout_steps.png

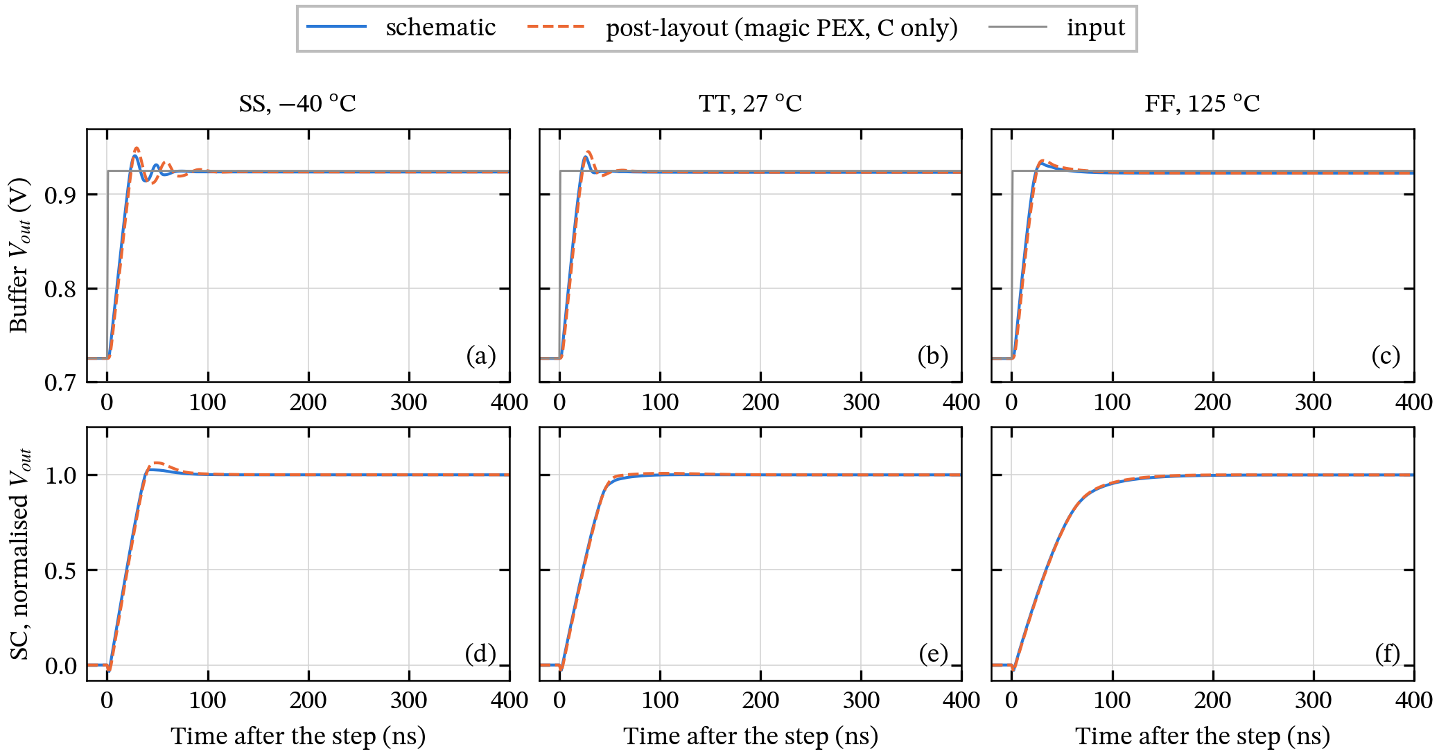
docs/figures/v2/fig_v2_postlayout_steps.png
