chennakeshavadasa/PVT-Invariant-Ring-Amplifier/sim/results/postlayout_sensitivity.csv

removed | corner | temp_c | a0_db | ugf_hz | pm_deg | gm_db
all parasitics removed | TT | 27 | 77.4276 | 1.90404e+07 | 61.5098 | 25.0313
all parasitics removed | SS | -40 | 83.1917 | 3.14301e+07 | 38.2008 | 15.9285
Vo_STG1 (stage-1 output) | TT | 27 | 77.4276 | 1.76213e+07 | 55.0772 | 24.5527
Vo_STG1 (stage-1 output) | SS | -40 | 83.1917 | 2.71305e+07 | 30.1335 | 13.365
mp_dz, mn_dz (stage-2 outputs) | TT | 27 | 77.4276 | 1.82534e+07 | 48.9987 | 14.9655
mp_dz, mn_dz (stage-2 outputs) | SS | -40 | 83.1917 | 2.87683e+07 | 18.1154 | 5.24718
V1_CM (trip-point replica) | TT | 27 | 77.4276 | 1.7227e+07 | 44.7691 | 14.3125
V1_CM (trip-point replica) | SS | -40 | 83.1917 | 2.61405e+07 | 16.4767 | 5.18445
VCTRLP, VCTRLN | TT | 27 | 77.4276 | 1.74267e+07 | 46.3026 | 14.7519
VCTRLP, VCTRLN | SS | -40 | 83.1917 | 2.66477e+07 | 18.855 | 6.02772
Vout | TT | 27 | 77.4276 | 1.72358e+07 | 44.4246 | 14.1128
Vout | SS | -40 | 83.1917 | 2.61271e+07 | 15.969 | 4.99187
