chennakeshavadasa/PVT-Invariant-Ring-Amplifier/sim/results/mc_summary.csv

set | bias | sample | seed | ok | vout | vctrlp | vctrln | vgp | vgn | vo1 | vcm1 | iq_ua | itot_ua | a0_db | ugf_hz | pm_deg | gm_db | sc_ts1_Sr_ns | sc_ts01_Sr_ns | sc_err250_Sr_pct | sc_errend_Sr_pct | sc_ts1_Sf_ns | sc_ts01_Sf_ns | sc_err250_Sf_pct | sc_errend_Sf_pct | sc_ts1_Lr_ns | sc_ts01_Lr_ns | sc_err250_Lr_pct | sc_errend_Lr_pct | sc_ts1_Lf_ns | sc_ts01_Lf_ns | sc_err250_Lf_pct | sc_errend_Lf_pct | offset_mv
process | reg | 0 | 1 | 1 | 0.823825 | 0.79043 | 0.792831 | 1.00508 | 0.708157 | 0.801641 | 0.801664 | 4.17876 | 148.756 | 76.6598 | 1.7285e+07 | 62.9207 | 25.4565 | 59.525 | 81.025 | 0.034 | 0.0688 | 48.025 | 60.525 | 0.02915 | 0.028975 | 41.3437 | 66.8437 | 0.034915 | 0.0497375 | 53.0519 | 78.0519 | 0.0299086 | 0.0298016 | -1.17533
process | reg | 1 | 2 | 1 | 0.824259 | 0.786409 | 0.789299 | 1.01378 | 0.700527 | 0.798472 | 0.798501 | 4.19661 | 166.727 | 77.377 | 1.9231e+07 | 63.0552 | 23.4821 | 54.525 | 76.025 | 0.0316738 | 0.06655 | 44.025 | 58.025 | 0.026775 | 0.0267 | 37.3049 | 59.8049 | 0.0324792 | 0.047388 | 47.4456 | 70.4456 | 0.0274959 | 0.0274389 | -0.741377
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
