chennakeshavadasa/PVT-Invariant-Ring-Amplifier/sim/results/postlayout_summary.csv

view | corner | temp_c | vdd | vout | vctrlp | vctrln | vgp | vgn | vo1 | vcm1 | iq_ua | itot_ua | a0_db | ugf_hz | pm_deg | gm_db | psrr_dc_db | psrr_1meg_db | dc_gain | ts1_rise_ns | ts01_rise_ns | err250_rise_pct | os_rise_pct | ts1_fall_ns | ts01_fall_ns | err250_fall_pct | os_fall_pct | idle_ripple_mv | offset_mv | sc_ts1_Sr_ns | sc_ts01_Sr_ns | sc_err250_Sr_pct | sc_errend_Sr_pct | sc_ts1_Sf_ns | sc_ts01_Sf_ns | sc_err250_Sf_pct | sc_errend_Sf_pct | sc_ts1_Lr_ns | sc_ts01_Lr_ns | sc_err250_Lr_pct | sc_errend_Lr_pct | sc_ts1_Lf_ns | sc_ts01_Lf_ns | sc_err250_Lf_pct | sc_errend_Lf_pct
sch | TT | -40 | 1.65 | 0.82475 | 0.828595 | 0.848131 | 0.931621 | 0.715277 | 0.830992 | 0.83093 | 4.19162 | 155.694 | 80.4618 | 2.87499e+07 | 50.3706 | 18.9174 | 46.7702 | 46.7196 | 0.994978 | 34.75 | 50.25 | 0.0006585 | 6.323 | 34.2434 | 49.7434 | 7.87434e-05 | 4.52923 | 0 | -0.250489 | 41.525 | 61.525 | 0.02365 | 0.058625 | 42.025 | 67.525 | 0.0188 | 0.018825 | 36.1865 | 60.1865 | 0.0243068 | 0.039279 | 34.3171 | 56.8171 | 0.0193158 | 0.0193048
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
