chennakeshavadasa/PVT-Invariant-Ring-Amplifier/sim/results/pvt_summary.csv

design | bias | corner | temp_c | vdd | vout | vctrlp | vctrln | vgp | vgn | vo1 | vcm1 | iq_ua | itot_ua | a0_db | ugf_hz | pm_deg | gm_db | psrr_dc_db | psrr_1meg_db | dc_gain | ts1_rise_ns | ts01_rise_ns | err250_rise_pct | os_rise_pct | ts1_fall_ns | ts01_fall_ns | err250_fall_pct | os_fall_pct | idle_ripple_mv | sc_ts1_Sr_ns | sc_ts01_Sr_ns | sc_err250_Sr_pct | sc_errend_Sr_pct | sc_ts1_Sf_ns | sc_ts01_Sf_ns | sc_err250_Sf_pct | sc_errend_Sf_pct | sc_ts1_Lr_ns | sc_ts01_Lr_ns | sc_err250_Lr_pct | sc_errend_Lr_pct | sc_ts1_Lf_ns | sc_ts01_Lf_ns | sc_err250_Lf_pct | sc_errend_Lf_pct
RAMP_LR | reg | TT | -40 | 1.5675 | 0.823774 | 0.768572 | 0.820003 | 0.850008 | 0.714075 | 0.78963 | 0.789577 | 4.09754 | 129.848 | 80.628 | 2.78997e+07 | 47.6356 | 19.0507 | 32.3734 | 32.4964 | 0.988614 | 39.25 | 65.75 | 0.00363575 | 5.90016 | 38.25 | 54.75 | 0.00034875 | 4.21965 | 0 | 43.525 | 70.525 | 0.023375 | 0.058275 | 43.525 | 71.525 | 0.0185238 | 0.0184737 | 40.2596 | 67.2596 | 0.0239856 | 0.0388635 | 38.289 | 63.789 | 0.0190049 | 0.0188808
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
