chennakeshavadasa/PVT-Invariant-Ring-Amplifier/Design Files/RAMP/RAMP-Test/RamP_tb1_CP_FB.png

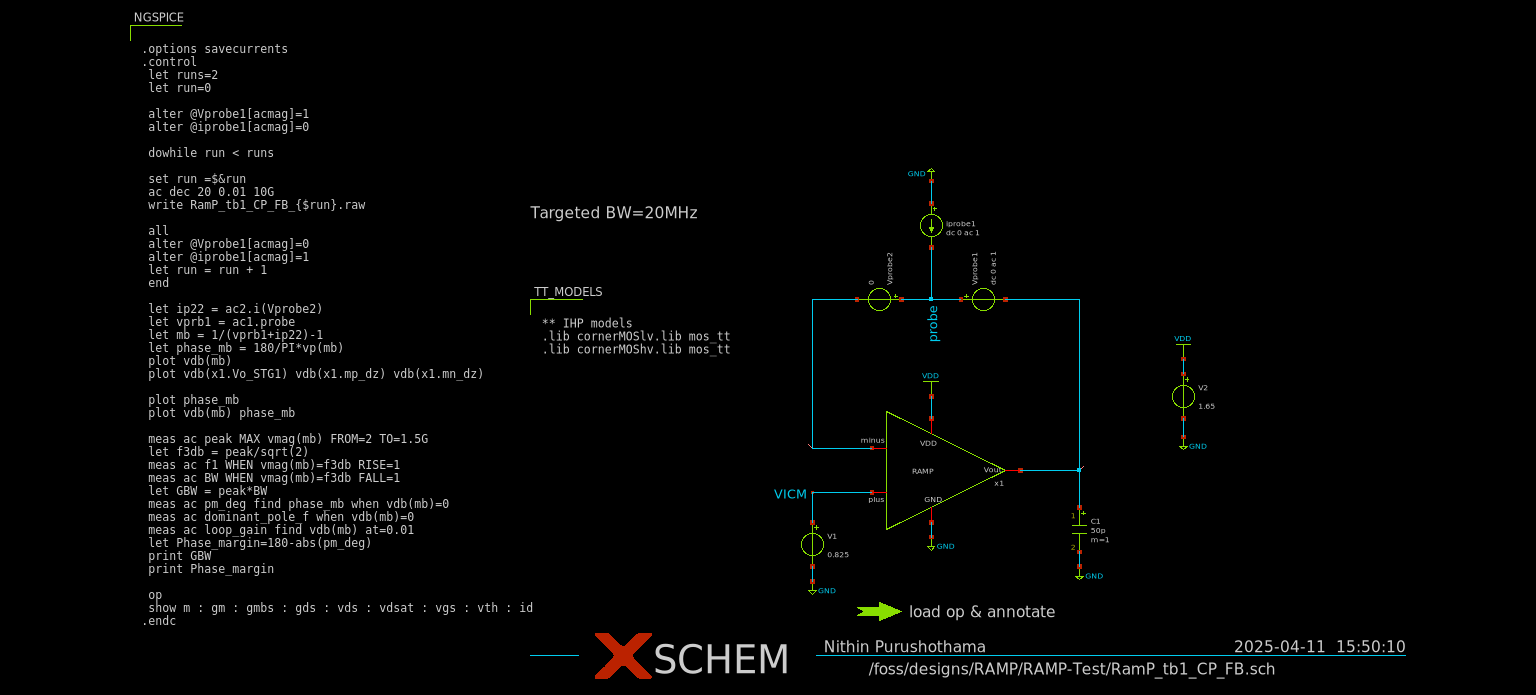
Design Files/RAMP/RAMP-Test/RamP_tb1_CP_FB.png
