chennakeshavadasa/PVT-Invariant-Ring-Amplifier/layout/pex/RAMP_V2_pex.spice

* NGSPICE file created from RAMP_V2.ext - technology: ihp-sg13g2

.subckt pc_pmos_8 a_268_0# a_896_n36# a_68_n36# a_344_n36# w_n62_n62# a_620_n36# sub  a_820_0# a_1096_0# a_544_0# a_0_0#
X0 a_820_0# a_620_n36# a_544_0# w_n62_n62# sg13_lv_pmos ad=0.38p pd=2.38u as=0.38p ps=2.38u w=2u l=1u
X1 a_544_0# a_344_n36# a_268_0# w_n62_n62# sg13_lv_pmos ad=0.38p pd=2.38u as=0.38p ps=2.38u w=2u l=1u
X2 a_1096_0# a_896_n36# a_820_0# w_n62_n62# sg13_lv_pmos ad=0.68p pd=4.68u as=0.38p ps=2.38u w=2u l=1u
X3 a_268_0# a_68_n36# a_0_0# w_n62_n62# sg13_lv_pmos ad=0.38p pd=2.38u as=0.68p ps=4.68u w=2u l=1u
C0 a_344_n36# a_268_0# 0.05528f
C1 a_544_0# w_n62_n62# 0.03593f
C2 a_820_0# a_896_n36# 0.05528f
C3 a_68_n36# a_0_0# 0.05528f
C4 a_344_n36# w_n62_n62# 0.23099f
C5 a_544_0# a_820_0# 0.05426f
C6 w_n62_n62# a_620_n36# 0.23099f
C7 a_344_n36# a_68_n36# 0.01172f
C8 a_1096_0# w_n62_n62# 0.03065f
C9 a_896_n36# a_620_n36# 0.01172f
C10 a_268_0# w_n62_n62# 0.03593f
C11 a_820_0# a_620_n36# 0.05528f
C12 a_344_n36# a_544_0# 0.05528f
C13 a_1096_0# a_896_n36# 0.05528f
C14 a_544_0# a_620_n36# 0.05528f
C15 a_820_0# a_1096_0# 0.05426f
C16 a_268_0# a_68_n36# 0.05528f
C17 a_268_0# a_0_0# 0.05426f
C18 a_344_n36# a_620_n36# 0.01172f
C19 a_268_0# a_544_0# 0.05426f
C20 w_n62_n62# a_896_n36# 0.23367f
C21 w_n62_n62# a_68_n36# 0.23367f
C22 a_820_0# w_n62_n62# 0.03593f
C23 w_n62_n62# a_0_0# 0.03065f
C24 a_1096_0# sub 0.07701f
C25 a_820_0# sub 0.01094f
C26 a_544_0# sub 0.01094f
C27 a_268_0# sub 0.01094f
C28 a_0_0# sub 0.07701f
C29 a_896_n36# sub 0.08376f
C30 a_620_n36# sub 0.0764f
C31 a_344_n36# sub 0.0764f
C32 a_68_n36# sub 0.08376f
.ends

.subckt pc_nmosHV_2 a_944_0# a_1496_n36# a_4752_0# a_1896_0# a_68_n36# a_3324_0# a_2372_0#  a_3400_n36# sub a_3800_0# a_2924_n36# a_4352_n36# a_1020_n36# a_2448_n36# a_4276_0#  a_468_0# a_1420_0# a_3876_n36# a_0_0# a_1972_n36# a_544_n36# a_2848_0#
X0 a_1896_0# a_1496_n36# a_1420_0# sub sg13_hv_nmos ad=57f pd=0.68u as=57f ps=0.68u w=0.3u l=2u
X1 a_2372_0# a_1972_n36# a_1896_0# sub sg13_hv_nmos ad=57f pd=0.68u as=57f ps=0.68u w=0.3u l=2u
X2 a_4276_0# a_3876_n36# a_3800_0# sub sg13_hv_nmos ad=57f pd=0.68u as=57f ps=0.68u w=0.3u l=2u
X3 a_2848_0# a_2448_n36# a_2372_0# sub sg13_hv_nmos ad=57f pd=0.68u as=57f ps=0.68u w=0.3u l=2u
X4 a_1420_0# a_1020_n36# a_944_0# sub sg13_hv_nmos ad=57f pd=0.68u as=57f ps=0.68u w=0.3u l=2u
X5 a_4752_0# a_4352_n36# a_4276_0# sub sg13_hv_nmos ad=0.102p pd=1.28u as=57f ps=0.68u w=0.3u l=2u
X6 a_944_0# a_544_n36# a_468_0# sub sg13_hv_nmos ad=57f pd=0.68u as=57f ps=0.68u w=0.3u l=2u
X7 a_3324_0# a_2924_n36# a_2848_0# sub sg13_hv_nmos ad=57f pd=0.68u as=57f ps=0.68u w=0.3u l=2u
X8 a_3800_0# a_3400_n36# a_3324_0# sub sg13_hv_nmos ad=57f pd=0.68u as=57f ps=0.68u w=0.3u l=2u
X9 a_468_0# a_68_n36# a_0_0# sub sg13_hv_nmos ad=57f pd=0.68u as=0.102p ps=1.28u w=0.3u l=2u
C0 a_468_0# a_544_n36# 0.01044f
C1 a_1972_n36# a_1896_0# 0.01044f
C2 a_4276_0# a_4352_n36# 0.01044f
C3 a_68_n36# a_544_n36# 0.01172f
C4 a_1496_n36# a_1896_0# 0.01044f
C5 a_3400_n36# a_3324_0# 0.01044f
C6 a_2924_n36# a_3400_n36# 0.01172f
C7 a_1020_n36# a_1420_0# 0.01044f
C8 a_3876_n36# a_4276_0# 0.01044f
C9 a_1496_n36# a_1972_n36# 0.01172f
C10 a_2924_n36# a_2848_0# 0.01044f
C11 a_0_0# a_68_n36# 0.01044f
C12 a_944_0# a_544_n36# 0.01044f
C13 a_1972_n36# a_2372_0# 0.01044f
C14 a_4752_0# a_4352_n36# 0.01044f
C15 a_2448_n36# a_2848_0# 0.01044f
C16 a_3400_n36# a_3800_0# 0.01044f
C17 a_1972_n36# a_2448_n36# 0.01172f
C18 a_2924_n36# a_3324_0# 0.01044f
C19 a_1496_n36# a_1420_0# 0.01044f
C20 a_1020_n36# a_544_n36# 0.01172f
C21 a_3876_n36# a_3800_0# 0.01044f
C22 a_3876_n36# a_3400_n36# 0.01172f
C23 a_3876_n36# a_4352_n36# 0.01172f
C24 a_1020_n36# a_1496_n36# 0.01172f
C25 a_468_0# a_68_n36# 0.01044f
C26 a_2924_n36# a_2448_n36# 0.01172f
C27 a_1020_n36# a_944_0# 0.01044f
C28 a_2448_n36# a_2372_0# 0.01044f
C29 a_4752_0# sub 0.02417f
C30 a_4276_0# sub 0.01267f
C31 a_3800_0# sub 0.01267f
C32 a_3324_0# sub 0.01267f
C33 a_2848_0# sub 0.01267f
C34 a_2372_0# sub 0.01267f
C35 a_1896_0# sub 0.01267f
C36 a_1420_0# sub 0.01267f
C37 a_944_0# sub 0.01267f
C38 a_468_0# sub 0.01267f
C39 a_0_0# sub 0.02417f
C40 a_4352_n36# sub 0.31558f
C41 a_3876_n36# sub 0.30553f
C42 a_3400_n36# sub 0.30553f
C43 a_2924_n36# sub 0.30553f
C44 a_2448_n36# sub 0.30553f
C45 a_1972_n36# sub 0.30553f
C46 a_1496_n36# sub 0.30553f
C47 a_1020_n36# sub 0.30553f
C48 a_544_n36# sub 0.30553f
C49 a_68_n36# sub 0.31558f
.ends

.subckt pc_nmos_10 a_442_15# a_100_15# a_328_15# a_188_n21# a_74_n21# a_670_15# sub a_556_15#  a_214_15# a_302_n21# a_0_0# a_416_n21# a_530_n21# a_644_n21#
X0 a_670_15# a_644_n21# a_556_15# sub sg13_lv_nmos ad=0.1005p pd=1.34u as=55.5f ps=0.74u w=0.15u l=0.13u
X1 a_328_15# a_302_n21# a_214_15# sub sg13_lv_nmos ad=55.5f pd=0.74u as=55.5f ps=0.74u w=0.15u l=0.13u
X2 a_556_15# a_530_n21# a_442_15# sub sg13_lv_nmos ad=55.5f pd=0.74u as=55.5f ps=0.74u w=0.15u l=0.13u
X3 a_100_15# a_74_n21# a_0_0# sub sg13_lv_nmos ad=55.5f pd=0.74u as=0.1005p ps=1.34u w=0.15u l=0.13u
X4 a_214_15# a_188_n21# a_100_15# sub sg13_lv_nmos ad=55.5f pd=0.74u as=55.5f ps=0.74u w=0.15u l=0.13u
X5 a_442_15# a_416_n21# a_328_15# sub sg13_lv_nmos ad=55.5f pd=0.74u as=55.5f ps=0.74u w=0.15u l=0.13u
C0 a_214_15# a_328_15# 0.02238f
C1 a_670_15# a_556_15# 0.02238f
C2 a_530_n21# a_416_n21# 0.01005f
C3 a_100_15# a_214_15# 0.02238f
C4 a_530_n21# a_644_n21# 0.01005f
C5 a_74_n21# a_188_n21# 0.01005f
C6 a_302_n21# a_416_n21# 0.01005f
C7 a_0_0# a_100_15# 0.02238f
C8 a_442_15# a_556_15# 0.02238f
C9 a_442_15# a_328_15# 0.02238f
C10 a_188_n21# a_302_n21# 0.01005f
C11 a_670_15# sub 0.02279f
C12 a_644_n21# sub 0.0401f
C13 a_556_15# sub 0.01308f
C14 a_530_n21# sub 0.03076f
C15 a_442_15# sub 0.01308f
C16 a_416_n21# sub 0.03076f
C17 a_328_15# sub 0.01308f
C18 a_302_n21# sub 0.03076f
C19 a_214_15# sub 0.01308f
C20 a_188_n21# sub 0.03076f
C21 a_100_15# sub 0.01308f
C22 a_74_n21# sub 0.0401f
C23 a_0_0# sub 0.02279f
.ends

.subckt pc_cmim sub c1_0_0# m5_n120_n120#
X0 c1_0_0# m5_n120_n120# cap_cmim l=51.6u w=51.6u
C0 c1_0_0# m5_n120_n120# 4.18997f
C1 c1_0_0# sub 7.40857f
C2 m5_n120_n120# sub 25.7077f
.ends

.subckt pc_rhigh a_0_1146# sub a_0_n86# a_0_0#
X0 a_0_1146# a_0_n86# sub rhigh l=5.73u w=0.5u
C0 a_0_0# a_0_1146# 0.01781f
C1 a_0_0# a_0_n86# 0.01781f
C2 a_0_n86# sub 0.11782f
C3 a_0_0# sub 0.76089f
C4 a_0_1146# sub 0.11782f
.ends

.subckt pc_pmos_6 a_268_0# a_68_n36# a_344_n36# w_n62_n62# sub a_544_0# a_0_0#
X0 a_544_0# a_344_n36# a_268_0# w_n62_n62# sg13_lv_pmos ad=1.36p pd=8.68u as=0.76p ps=4.38u w=4u l=1u
X1 a_268_0# a_68_n36# a_0_0# w_n62_n62# sg13_lv_pmos ad=0.76p pd=4.38u as=1.36p ps=8.68u w=4u l=1u
C0 a_68_n36# w_n62_n62# 0.40854f
C1 w_n62_n62# a_0_0# 0.05653f
C2 a_344_n36# w_n62_n62# 0.40854f
C3 a_68_n36# a_268_0# 0.11057f
C4 a_544_0# a_344_n36# 0.11057f
C5 a_268_0# a_0_0# 0.10853f
C6 a_344_n36# a_268_0# 0.11057f
C7 a_544_0# w_n62_n62# 0.05653f
C8 a_68_n36# a_0_0# 0.11057f
C9 w_n62_n62# a_268_0# 0.06444f
C10 a_68_n36# a_344_n36# 0.01172f
C11 a_544_0# a_268_0# 0.10853f
C12 a_544_0# sub 0.14307f
C13 a_268_0# sub 0.01094f
C14 a_0_0# sub 0.14307f
C15 a_344_n36# sub 0.08376f
C16 a_68_n36# sub 0.08376f
.ends

.subckt pc_nmos_9 a_442_15# a_100_15# a_328_15# a_188_n21# a_74_n21# sub a_214_15# a_302_n21#  a_0_0# a_416_n21#
X0 a_328_15# a_302_n21# a_214_15# sub sg13_lv_nmos ad=55.5f pd=0.74u as=55.5f ps=0.74u w=0.15u l=0.13u
X1 a_100_15# a_74_n21# a_0_0# sub sg13_lv_nmos ad=55.5f pd=0.74u as=0.1005p ps=1.34u w=0.15u l=0.13u
X2 a_214_15# a_188_n21# a_100_15# sub sg13_lv_nmos ad=55.5f pd=0.74u as=55.5f ps=0.74u w=0.15u l=0.13u
X3 a_442_15# a_416_n21# a_328_15# sub sg13_lv_nmos ad=0.1005p pd=1.34u as=55.5f ps=0.74u w=0.15u l=0.13u
C0 a_302_n21# a_188_n21# 0.01005f
C1 a_100_15# a_0_0# 0.02238f
C2 a_328_15# a_442_15# 0.02238f
C3 a_100_15# a_214_15# 0.02238f
C4 a_302_n21# a_416_n21# 0.01005f
C5 a_74_n21# a_188_n21# 0.01005f
C6 a_328_15# a_214_15# 0.02238f
C7 a_442_15# sub 0.02279f
C8 a_416_n21# sub 0.0401f
C9 a_328_15# sub 0.01308f
C10 a_302_n21# sub 0.03076f
C11 a_214_15# sub 0.01308f
C12 a_188_n21# sub 0.03076f
C13 a_100_15# sub 0.01308f
C14 a_74_n21# sub 0.0401f
C15 a_0_0# sub 0.02279f
.ends

.subckt pc_pmos_4 a_268_0# a_68_n36# w_n62_n62# sub a_0_0#
X0 a_268_0# a_68_n36# a_0_0# w_n62_n62# sg13_lv_pmos ad=1.36p pd=8.68u as=1.36p ps=8.68u w=4u l=1u
C0 a_268_0# a_68_n36# 0.11057f
C1 a_268_0# w_n62_n62# 0.05653f
C2 a_0_0# a_68_n36# 0.11057f
C3 w_n62_n62# a_0_0# 0.05653f
C4 a_268_0# a_0_0# 0.10853f
C5 w_n62_n62# a_68_n36# 0.41122f
C6 a_268_0# sub 0.14307f
C7 a_0_0# sub 0.14307f
C8 a_68_n36# sub 0.09113f
.ends

.subckt pc_cmim_1 sub c1_0_0# m5_n120_n120#
X0 c1_0_0# m5_n120_n120# cap_cmim l=25.8u w=25.8u
C0 m5_n120_n120# c1_0_0# 1.70963f
C1 c1_0_0# sub 3.6064f
C2 m5_n120_n120# sub 8.17506f
.ends

.subckt pc_nmos_7 a_944_0# a_68_n36# sub a_1020_n36# a_468_0# a_1420_0# a_0_0# a_544_n36#
X0 a_1420_0# a_1020_n36# a_944_0# sub sg13_lv_nmos ad=0.34p pd=2.68u as=0.19p ps=1.38u w=1u l=2u
X1 a_944_0# a_544_n36# a_468_0# sub sg13_lv_nmos ad=0.19p pd=1.38u as=0.19p ps=1.38u w=1u l=2u
X2 a_468_0# a_68_n36# a_0_0# sub sg13_lv_nmos ad=0.19p pd=1.38u as=0.34p ps=2.68u w=1u l=2u
C0 a_544_n36# a_944_0# 0.03479f
C1 a_1420_0# a_944_0# 0.01424f
C2 a_468_0# a_544_n36# 0.03479f
C3 a_0_0# a_68_n36# 0.03479f
C4 a_1020_n36# a_544_n36# 0.01172f
C5 a_68_n36# a_468_0# 0.03479f
C6 a_468_0# a_944_0# 0.01424f
C7 a_1020_n36# a_1420_0# 0.03479f
C8 a_1020_n36# a_944_0# 0.03479f
C9 a_0_0# a_468_0# 0.01424f
C10 a_68_n36# a_544_n36# 0.01172f
C11 a_1420_0# sub 0.05102f
C12 a_944_0# sub 0.01267f
C13 a_468_0# sub 0.01267f
C14 a_0_0# sub 0.05102f
C15 a_1020_n36# sub 0.43798f
C16 a_544_n36# sub 0.42794f
C17 a_68_n36# sub 0.43798f
.ends

.subckt pc_pmos_2 a_100_15# w_n62_n62# a_74_n21# sub a_0_0#
X0 a_100_15# a_74_n21# a_0_0# w_n62_n62# sg13_lv_pmos ad=0.1005p pd=1.34u as=0.1005p ps=1.34u w=0.15u l=0.13u
C0 a_0_0# a_100_15# 0.02238f
C1 w_n62_n62# a_74_n21# 0.02613f
C2 a_100_15# sub 0.01942f
C3 a_74_n21# sub 0.02332f
C4 a_0_0# sub 0.01942f
.ends

.subckt pc_nmos_5 a_68_n36# sub a_468_0# a_0_0#
X0 a_468_0# a_68_n36# a_0_0# sub sg13_lv_nmos ad=0.34p pd=2.68u as=0.34p ps=2.68u w=1u l=2u
C0 a_68_n36# a_468_0# 0.03479f
C1 a_0_0# a_468_0# 0.01424f
C2 a_68_n36# a_0_0# 0.03479f
C3 a_468_0# sub 0.05102f
C4 a_0_0# sub 0.05102f
C5 a_68_n36# sub 0.44803f
.ends

.subckt pc_nmosHV_7 a_268_0# a_896_n36# a_68_n36# a_344_n36# a_1648_0# a_1172_n36# a_1372_0#  a_620_n36# sub a_820_0# a_1448_n36# a_1096_0# a_544_0# a_0_0#
X0 a_820_0# a_620_n36# a_544_0# sub sg13_hv_nmos ad=0.2185p pd=1.53u as=0.2185p ps=1.53u w=1.15u l=1u
X1 a_544_0# a_344_n36# a_268_0# sub sg13_hv_nmos ad=0.2185p pd=1.53u as=0.2185p ps=1.53u w=1.15u l=1u
X2 a_1096_0# a_896_n36# a_820_0# sub sg13_hv_nmos ad=0.2185p pd=1.53u as=0.2185p ps=1.53u w=1.15u l=1u
X3 a_1648_0# a_1448_n36# a_1372_0# sub sg13_hv_nmos ad=0.391p pd=2.98u as=0.2185p ps=1.53u w=1.15u l=1u
X4 a_268_0# a_68_n36# a_0_0# sub sg13_hv_nmos ad=0.2185p pd=1.53u as=0.391p ps=2.98u w=1.15u l=1u
X5 a_1372_0# a_1172_n36# a_1096_0# sub sg13_hv_nmos ad=0.2185p pd=1.53u as=0.2185p ps=1.53u w=1.15u l=1u
C0 a_1372_0# a_1448_n36# 0.03179f
C1 a_1096_0# a_820_0# 0.03123f
C2 a_1096_0# a_1172_n36# 0.03179f
C3 a_1372_0# a_1648_0# 0.03123f
C4 a_1096_0# a_1372_0# 0.03123f
C5 a_896_n36# a_620_n36# 0.01172f
C6 a_544_0# a_620_n36# 0.03179f
C7 a_268_0# a_68_n36# 0.03179f
C8 a_268_0# a_344_n36# 0.03179f
C9 a_68_n36# a_0_0# 0.03179f
C10 a_820_0# a_896_n36# 0.03179f
C11 a_544_0# a_820_0# 0.03123f
C12 a_1172_n36# a_896_n36# 0.01172f
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
C48 a_1400_0# sub 0.13645f
C49 a_0_0# sub 0.13645f
C50 a_1300_n36# sub 0.03143f
C51 a_1124_n36# sub 0.02594f
C52 a_948_n36# sub 0.02594f
C53 a_772_n36# sub 0.02594f
C54 a_596_n36# sub 0.02594f
C55 a_420_n36# sub 0.02594f
C56 a_244_n36# sub 0.02594f
C57 a_68_n36# sub 0.03143f
.ends

.subckt pc_nmos_3 a_100_15# a_188_n21# a_74_n21# sub a_214_15# a_0_0#
X0 a_100_15# a_74_n21# a_0_0# sub sg13_lv_nmos ad=55.5f pd=0.74u as=0.1005p ps=1.34u w=0.15u l=0.13u
X1 a_214_15# a_188_n21# a_100_15# sub sg13_lv_nmos ad=0.1005p pd=1.34u as=55.5f ps=0.74u w=0.15u l=0.13u
C0 a_100_15# a_214_15# 0.02238f
C1 a_188_n21# a_74_n21# 0.01005f
C2 a_100_15# a_0_0# 0.02238f
C3 a_214_15# sub 0.02279f
C4 a_188_n21# sub 0.0401f
C5 a_100_15# sub 0.01308f
C6 a_74_n21# sub 0.0401f
C7 a_0_0# sub 0.02279f
.ends

.subckt pc_nmosHV_5 a_68_n36# a_668_0# sub a_0_0#
X0 a_668_0# a_68_n36# a_0_0# sub sg13_hv_nmos ad=1.02p pd=6.68u as=1.02p ps=6.68u w=3u l=3u
C0 a_0_0# a_68_n36# 0.11296f
C1 a_668_0# a_0_0# 0.02872f
C2 a_668_0# a_68_n36# 0.11296f
C3 a_668_0# sub 0.12772f
C4 a_0_0# sub 0.12772f
C5 a_68_n36# sub 1.18061f
.ends

.subckt pc_pmosHV_2 a_268_0# a_68_n36# w_n124_n124# sub a_0_0#
X0 a_268_0# a_68_n36# a_0_0# w_n124_n124# sg13_hv_pmos ad=0.34p pd=2.68u as=0.34p ps=2.68u w=1u l=1u
C0 a_68_n36# w_n124_n124# 0.17719f
C1 a_0_0# a_268_0# 0.02715f
C2 a_0_0# a_68_n36# 0.02764f
C3 a_268_0# a_68_n36# 0.02764f
C4 a_0_0# w_n124_n124# 0.02256f
C5 a_268_0# w_n124_n124# 0.02256f
C6 a_268_0# sub 0.03761f
C7 a_0_0# sub 0.03761f
C8 a_68_n36# sub 0.06285f
.ends

.subckt pc_nmos a_68_n36# a_3420_n36# sub a_6696_0# a_5020_0# a_1744_n36# a_3344_0# a_5096_n36#  a_0_0# a_1668_0#
X0 a_6696_0# a_5096_n36# a_5020_0# sub sg13_lv_nmos ad=0.17p pd=1.68u as=95f ps=0.88u w=0.5u l=8u
X1 a_3344_0# a_1744_n36# a_1668_0# sub sg13_lv_nmos ad=95f pd=0.88u as=95f ps=0.88u w=0.5u l=8u
X2 a_5020_0# a_3420_n36# a_3344_0# sub sg13_lv_nmos ad=95f pd=0.88u as=95f ps=0.88u w=0.5u l=8u
X3 a_1668_0# a_68_n36# a_0_0# sub sg13_lv_nmos ad=95f pd=0.88u as=0.17p ps=1.68u w=0.5u l=8u
C0 a_1668_0# a_1744_n36# 0.02075f
C1 a_0_0# a_68_n36# 0.02075f
C2 a_1744_n36# a_68_n36# 0.01172f
C3 a_3420_n36# a_3344_0# 0.02075f
C4 a_1668_0# a_68_n36# 0.02075f
C5 a_3344_0# a_1744_n36# 0.02075f
C6 a_3420_n36# a_5020_0# 0.02075f
C7 a_5096_n36# a_5020_0# 0.02075f
C8 a_3420_n36# a_5096_n36# 0.01172f
C9 a_3420_n36# a_1744_n36# 0.01172f
C10 a_5096_n36# a_6696_0# 0.02075f
C11 a_6696_0# sub 0.03407f
C12 a_5020_0# sub 0.01712f
C13 a_3344_0# sub 0.01712f
C14 a_1668_0# sub 0.01712f
C15 a_0_0# sub 0.03407f
C16 a_5096_n36# sub 1.33615f
C17 a_3420_n36# sub 1.3261f
C18 a_1744_n36# sub 1.3261f
C19 a_68_n36# sub 1.33615f
.ends

.subckt pc_nmos_1 a_68_n36# a_3420_n36# sub a_5020_0# a_1744_n36# a_3344_0# a_0_0# a_1668_0#
X0 a_3344_0# a_1744_n36# a_1668_0# sub sg13_lv_nmos ad=95f pd=0.88u as=95f ps=0.88u w=0.5u l=8u
X1 a_5020_0# a_3420_n36# a_3344_0# sub sg13_lv_nmos ad=0.17p pd=1.68u as=95f ps=0.88u w=0.5u l=8u
X2 a_1668_0# a_68_n36# a_0_0# sub sg13_lv_nmos ad=95f pd=0.88u as=0.17p ps=1.68u w=0.5u l=8u
C0 a_1744_n36# a_1668_0# 0.02075f
C1 a_5020_0# a_3420_n36# 0.02075f
C2 a_0_0# a_68_n36# 0.02075f
C3 a_3420_n36# a_3344_0# 0.02075f
C4 a_1744_n36# a_3344_0# 0.02075f
C5 a_1744_n36# a_3420_n36# 0.01172f
C6 a_68_n36# a_1668_0# 0.02075f
C7 a_1744_n36# a_68_n36# 0.01172f
C8 a_5020_0# sub 0.03407f
C9 a_3344_0# sub 0.01712f
C10 a_1668_0# sub 0.01712f
C11 a_0_0# sub 0.03407f
C12 a_3420_n36# sub 1.33615f
C13 a_1744_n36# sub 1.3261f
C14 a_68_n36# sub 1.33615f
.ends

.subckt pc_pmos_9 a_442_15# a_100_15# a_758_n21# a_872_n21# a_986_n21# a_328_15# w_n62_n62#  a_188_n21# a_74_n21# a_670_15# sub a_898_15# a_556_15# a_214_15# a_1012_15# a_302_n21#  a_0_0# a_416_n21# a_530_n21# a_784_15# a_644_n21#
X0 a_670_15# a_644_n21# a_556_15# w_n62_n62# sg13_lv_pmos ad=55.5f pd=0.74u as=55.5f ps=0.74u w=0.15u l=0.13u
X1 a_898_15# a_872_n21# a_784_15# w_n62_n62# sg13_lv_pmos ad=55.5f pd=0.74u as=55.5f ps=0.74u w=0.15u l=0.13u
X2 a_328_15# a_302_n21# a_214_15# w_n62_n62# sg13_lv_pmos ad=55.5f pd=0.74u as=55.5f ps=0.74u w=0.15u l=0.13u
X3 a_556_15# a_530_n21# a_442_15# w_n62_n62# sg13_lv_pmos ad=55.5f pd=0.74u as=55.5f ps=0.74u w=0.15u l=0.13u
X4 a_100_15# a_74_n21# a_0_0# w_n62_n62# sg13_lv_pmos ad=55.5f pd=0.74u as=0.1005p ps=1.34u w=0.15u l=0.13u
X5 a_784_15# a_758_n21# a_670_15# w_n62_n62# sg13_lv_pmos ad=55.5f pd=0.74u as=55.5f ps=0.74u w=0.15u l=0.13u
X6 a_214_15# a_188_n21# a_100_15# w_n62_n62# sg13_lv_pmos ad=55.5f pd=0.74u as=55.5f ps=0.74u w=0.15u l=0.13u
X7 a_1012_15# a_986_n21# a_898_15# w_n62_n62# sg13_lv_pmos ad=0.1005p pd=1.34u as=55.5f ps=0.74u w=0.15u l=0.13u
X8 a_442_15# a_416_n21# a_328_15# w_n62_n62# sg13_lv_pmos ad=55.5f pd=0.74u as=55.5f ps=0.74u w=0.15u l=0.13u
C0 a_758_n21# a_644_n21# 0.01005f
C1 w_n62_n62# a_986_n21# 0.02392f
C2 a_758_n21# a_872_n21# 0.01005f
C3 a_784_15# a_898_15# 0.02238f
C4 a_530_n21# w_n62_n62# 0.02172f
C5 a_188_n21# w_n62_n62# 0.02172f
C6 w_n62_n62# a_416_n21# 0.02172f
C7 a_188_n21# a_302_n21# 0.01005f
C8 a_442_15# a_556_15# 0.02238f
C9 w_n62_n62# a_758_n21# 0.02172f
C10 w_n62_n62# a_74_n21# 0.02392f
C11 a_670_15# a_556_15# 0.02238f
C12 w_n62_n62# a_644_n21# 0.02172f
C13 a_302_n21# a_416_n21# 0.01005f
C14 w_n62_n62# a_872_n21# 0.02172f
C15 a_898_15# a_1012_15# 0.02238f
C16 a_872_n21# a_986_n21# 0.01005f
C17 a_670_15# a_784_15# 0.02238f
C18 a_442_15# a_328_15# 0.02238f
C19 a_530_n21# a_416_n21# 0.01005f
C20 a_214_15# a_328_15# 0.02238f
C21 a_100_15# a_214_15# 0.02238f
C22 a_530_n21# a_644_n21# 0.01005f
C23 a_188_n21# a_74_n21# 0.01005f
C24 a_100_15# a_0_0# 0.02238f
C25 w_n62_n62# a_302_n21# 0.02172f
C26 a_1012_15# sub 0.01942f
C27 a_986_n21# sub 0.01618f
C28 a_898_15# sub 0.01084f
C29 a_784_15# sub 0.01084f
C30 a_670_15# sub 0.01084f
C31 a_556_15# sub 0.01084f
C32 a_442_15# sub 0.01084f
C33 a_328_15# sub 0.01084f
C34 a_214_15# sub 0.01084f
C35 a_100_15# sub 0.01084f
C36 a_74_n21# sub 0.01618f
C37 a_0_0# sub 0.01942f
.ends

.subckt pc_nmosHV_3 a_68_n36# sub a_0_0# a_868_0#
X0 a_868_0# a_68_n36# a_0_0# sub sg13_hv_nmos ad=1.36p pd=8.68u as=1.36p ps=8.68u w=4u l=4u
C0 a_68_n36# a_868_0# 0.15667f
C1 a_68_n36# a_0_0# 0.15667f
C2 a_0_0# a_868_0# 0.02877f
C3 a_868_0# sub 0.16607f
C4 a_0_0# sub 0.16607f
C5 a_68_n36# sub 1.91319f
.ends

.subckt pc_nmosHV a_68_n36# sub a_468_0# a_0_0#
X0 a_468_0# a_68_n36# a_0_0# sub sg13_hv_nmos ad=0.102p pd=1.28u as=0.102p ps=1.28u w=0.3u l=2u
C0 a_68_n36# a_468_0# 0.01044f
C1 a_68_n36# a_0_0# 0.01044f
C2 a_468_0# sub 0.02417f
C3 a_0_0# sub 0.02417f
C4 a_68_n36# sub 0.32563f
.ends

.subckt pc_pmos_7 a_268_0# a_68_n36# w_n62_n62# sub a_0_0#
X0 a_268_0# a_68_n36# a_0_0# w_n62_n62# sg13_lv_pmos ad=0.68p pd=4.68u as=0.68p ps=4.68u w=2u l=1u
C0 w_n62_n62# a_0_0# 0.03065f
C1 a_68_n36# a_268_0# 0.05528f
C2 w_n62_n62# a_268_0# 0.03065f
C3 a_0_0# a_268_0# 0.05426f
C4 w_n62_n62# a_68_n36# 0.23635f
C5 a_68_n36# a_0_0# 0.05528f
C6 a_268_0# sub 0.07701f
C7 a_0_0# sub 0.07701f
C8 a_68_n36# sub 0.09113f
.ends

.subckt pc_nmosHV_1 a_944_0# a_1496_n36# a_4752_0# a_1896_0# a_68_n36# a_3324_0# a_5304_n36#  a_2372_0# a_6732_n36# a_3400_n36# sub a_6656_0# a_3800_0# a_4828_n36# a_6256_n36#  a_2924_n36# a_5228_0# a_4352_n36# a_5780_n36# a_1020_n36# a_7132_0# a_2448_n36#  a_4276_0# a_468_0# a_1420_0# a_3876_n36# a_0_0# a_1972_n36# a_6180_0# a_5704_0#  a_544_n36# a_2848_0#
X0 a_1896_0# a_1496_n36# a_1420_0# sub sg13_hv_nmos ad=57f pd=0.68u as=57f ps=0.68u w=0.3u l=2u
X1 a_2372_0# a_1972_n36# a_1896_0# sub sg13_hv_nmos ad=57f pd=0.68u as=57f ps=0.68u w=0.3u l=2u
X2 a_4276_0# a_3876_n36# a_3800_0# sub sg13_hv_nmos ad=57f pd=0.68u as=57f ps=0.68u w=0.3u l=2u
X3 a_2848_0# a_2448_n36# a_2372_0# sub sg13_hv_nmos ad=57f pd=0.68u as=57f ps=0.68u w=0.3u l=2u
X4 a_1420_0# a_1020_n36# a_944_0# sub sg13_hv_nmos ad=57f pd=0.68u as=57f ps=0.68u w=0.3u l=2u
X5 a_6180_0# a_5780_n36# a_5704_0# sub sg13_hv_nmos ad=57f pd=0.68u as=57f ps=0.68u w=0.3u l=2u
X6 a_4752_0# a_4352_n36# a_4276_0# sub sg13_hv_nmos ad=57f pd=0.68u as=57f ps=0.68u w=0.3u l=2u
X7 a_944_0# a_544_n36# a_468_0# sub sg13_hv_nmos ad=57f pd=0.68u as=57f ps=0.68u w=0.3u l=2u
X8 a_3324_0# a_2924_n36# a_2848_0# sub sg13_hv_nmos ad=57f pd=0.68u as=57f ps=0.68u w=0.3u l=2u
X9 a_6656_0# a_6256_n36# a_6180_0# sub sg13_hv_nmos ad=57f pd=0.68u as=57f ps=0.68u w=0.3u l=2u
X10 a_5228_0# a_4828_n36# a_4752_0# sub sg13_hv_nmos ad=57f pd=0.68u as=57f ps=0.68u w=0.3u l=2u
X11 a_3800_0# a_3400_n36# a_3324_0# sub sg13_hv_nmos ad=57f pd=0.68u as=57f ps=0.68u w=0.3u l=2u
X12 a_7132_0# a_6732_n36# a_6656_0# sub sg13_hv_nmos ad=0.102p pd=1.28u as=57f ps=0.68u w=0.3u l=2u
X13 a_468_0# a_68_n36# a_0_0# sub sg13_hv_nmos ad=57f pd=0.68u as=0.102p ps=1.28u w=0.3u l=2u
X14 a_5704_0# a_5304_n36# a_5228_0# sub sg13_hv_nmos ad=57f pd=0.68u as=57f ps=0.68u w=0.3u l=2u
C0 a_5304_n36# a_5228_0# 0.01044f
C1 a_1420_0# a_1020_n36# 0.01044f
C2 a_468_0# a_544_n36# 0.01044f
C3 a_2924_n36# a_2448_n36# 0.01172f
C4 a_3400_n36# a_2924_n36# 0.01172f
C5 a_1496_n36# a_1972_n36# 0.01172f
C6 a_4276_0# a_4352_n36# 0.01044f
C7 a_5780_n36# a_6256_n36# 0.01172f
C8 a_6732_n36# a_6656_0# 0.01044f
C9 a_944_0# a_1020_n36# 0.01044f
C10 a_3876_n36# a_4352_n36# 0.01172f
C11 a_6732_n36# a_6256_n36# 0.01172f
C12 a_6256_n36# a_6180_0# 0.01044f
C13 a_5780_n36# a_5704_0# 0.01044f
C14 a_3876_n36# a_3800_0# 0.01044f
C15 a_4752_0# a_4352_n36# 0.01044f
C16 a_1896_0# a_1496_n36# 0.01044f
C17 a_2924_n36# a_3324_0# 0.01044f
C18 a_2848_0# a_2924_n36# 0.01044f
C19 a_3400_n36# a_3324_0# 0.01044f
C20 a_2848_0# a_2448_n36# 0.01044f
C21 a_1896_0# a_1972_n36# 0.01044f
C22 a_0_0# a_68_n36# 0.01044f
C23 a_468_0# a_68_n36# 0.01044f
C24 a_2372_0# a_1972_n36# 0.01044f
C25 a_5304_n36# a_5704_0# 0.01044f
C26 a_1420_0# a_1496_n36# 0.01044f
C27 a_4752_0# a_4828_n36# 0.01044f
C28 a_1020_n36# a_1496_n36# 0.01172f
C29 a_6732_n36# a_7132_0# 0.01044f
C30 a_3400_n36# a_3876_n36# 0.01172f
C31 a_4828_n36# a_4352_n36# 0.01172f
C32 a_68_n36# a_544_n36# 0.01172f
C33 a_6256_n36# a_6656_0# 0.01044f
C34 a_5780_n36# a_6180_0# 0.01044f
C35 a_1972_n36# a_2448_n36# 0.01172f
C36 a_544_n36# a_1020_n36# 0.01172f
C37 a_3400_n36# a_3800_0# 0.01044f
C38 a_944_0# a_544_n36# 0.01044f
C39 a_5304_n36# a_5780_n36# 0.01172f
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
C44 a_7132_0# sub 0.02417f
C45 a_6656_0# sub 0.01267f
C46 a_6180_0# sub 0.01267f
C47 a_5704_0# sub 0.01267f
C48 a_5228_0# sub 0.01267f
C49 a_4752_0# sub 0.01267f
C50 a_4276_0# sub 0.01267f
C51 a_3800_0# sub 0.01267f
C52 a_3324_0# sub 0.01267f
C53 a_2848_0# sub 0.01267f
C54 a_2372_0# sub 0.01267f
C55 a_1896_0# sub 0.01267f
C56 a_1420_0# sub 0.01267f
C57 a_944_0# sub 0.01267f
C58 a_468_0# sub 0.01267f
C59 a_0_0# sub 0.02417f
C60 a_6732_n36# sub 0.31558f
C61 a_6256_n36# sub 0.30553f
C62 a_5780_n36# sub 0.30553f
C63 a_5304_n36# sub 0.30553f
C64 a_4828_n36# sub 0.30553f
C65 a_4352_n36# sub 0.30553f
C66 a_3876_n36# sub 0.30553f
C67 a_3400_n36# sub 0.30553f
C68 a_2924_n36# sub 0.30553f
C69 a_2448_n36# sub 0.30553f
C70 a_1972_n36# sub 0.30553f
C71 a_1496_n36# sub 0.30553f
C72 a_1020_n36# sub 0.30553f
C73 a_544_n36# sub 0.30553f
C74 a_68_n36# sub 0.31558f
.ends
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
