chennakeshavadasa/PVT-Invariant-Ring-Amplifier/layout/pex/RAMP_LR_pex.spice

* NGSPICE file created from RAMP_LR.ext - technology: ihp-sg13g2

.subckt pc_nmosHV_2 a_268_0# a_68_n36# sub a_0_0#
X0 a_268_0# a_68_n36# a_0_0# sub sg13_hv_nmos ad=0.595p pd=4.18u as=0.595p ps=4.18u w=1.75u l=1u
C0 a_268_0# a_68_n36# 0.04837f
C1 a_0_0# a_68_n36# 0.04837f
C2 a_0_0# a_268_0# 0.04752f
C3 a_268_0# sub 0.07978f
C4 a_0_0# sub 0.07978f
C5 a_68_n36# sub 0.30562f
.ends

.subckt pc_cmim sub c1_0_0# m5_n120_n120#
X0 c1_0_0# m5_n120_n120# cap_cmim l=36.5u w=36.5u
C0 c1_0_0# m5_n120_n120# 2.94342f
C1 c1_0_0# sub 5.2363f
C2 m5_n120_n120# sub 14.2934f
.ends

.subckt pc_pmos_6 a_442_15# a_100_15# a_758_n21# a_872_n21# a_986_n21# a_328_15# w_n62_n62#  a_188_n21# a_74_n21# a_670_15# sub a_898_15# a_556_15# a_214_15# a_1012_15# a_302_n21#  a_0_0# a_416_n21# a_530_n21# a_784_15# a_644_n21#
X0 a_670_15# a_644_n21# a_556_15# w_n62_n62# sg13_lv_pmos ad=55.5f pd=0.74u as=55.5f ps=0.74u w=0.15u l=0.13u
X1 a_898_15# a_872_n21# a_784_15# w_n62_n62# sg13_lv_pmos ad=55.5f pd=0.74u as=55.5f ps=0.74u w=0.15u l=0.13u
X2 a_328_15# a_302_n21# a_214_15# w_n62_n62# sg13_lv_pmos ad=55.5f pd=0.74u as=55.5f ps=0.74u w=0.15u l=0.13u
X3 a_556_15# a_530_n21# a_442_15# w_n62_n62# sg13_lv_pmos ad=55.5f pd=0.74u as=55.5f ps=0.74u w=0.15u l=0.13u
X4 a_100_15# a_74_n21# a_0_0# w_n62_n62# sg13_lv_pmos ad=55.5f pd=0.74u as=0.1005p ps=1.34u w=0.15u l=0.13u
X5 a_784_15# a_758_n21# a_670_15# w_n62_n62# sg13_lv_pmos ad=55.5f pd=0.74u as=55.5f ps=0.74u w=0.15u l=0.13u
X6 a_214_15# a_188_n21# a_100_15# w_n62_n62# sg13_lv_pmos ad=55.5f pd=0.74u as=55.5f ps=0.74u w=0.15u l=0.13u
X7 a_1012_15# a_986_n21# a_898_15# w_n62_n62# sg13_lv_pmos ad=0.1005p pd=1.34u as=55.5f ps=0.74u w=0.15u l=0.13u
X8 a_442_15# a_416_n21# a_328_15# w_n62_n62# sg13_lv_pmos ad=55.5f pd=0.74u as=55.5f ps=0.74u w=0.15u l=0.13u
C0 a_328_15# a_442_15# 0.02238f
C1 a_898_15# a_784_15# 0.02238f
C2 a_530_n21# a_644_n21# 0.01005f
C3 a_416_n21# a_530_n21# 0.01005f
C4 a_302_n21# a_416_n21# 0.01005f
C5 a_872_n21# a_758_n21# 0.01005f
C6 a_644_n21# w_n62_n62# 0.02172f
C7 a_416_n21# w_n62_n62# 0.02172f
C8 a_670_15# a_784_15# 0.02238f
C9 a_530_n21# w_n62_n62# 0.02172f
C10 a_302_n21# a_188_n21# 0.01005f
C11 a_302_n21# w_n62_n62# 0.02172f
C12 w_n62_n62# a_188_n21# 0.02172f
C13 a_986_n21# w_n62_n62# 0.02392f
C14 a_644_n21# a_758_n21# 0.01005f
C15 a_74_n21# a_188_n21# 0.01005f
C16 a_74_n21# w_n62_n62# 0.02392f
C17 a_898_15# a_1012_15# 0.02238f
C18 a_100_15# a_214_15# 0.02238f
C19 a_872_n21# w_n62_n62# 0.02172f
C20 a_556_15# a_670_15# 0.02238f
C21 a_872_n21# a_986_n21# 0.01005f
C22 a_328_15# a_214_15# 0.02238f
C23 a_0_0# a_100_15# 0.02238f
C24 w_n62_n62# a_758_n21# 0.02172f
C25 a_442_15# a_556_15# 0.02238f
C26 a_1012_15# sub 0.01942f
C27 a_986_n21# sub 0.01618f
C28 a_898_15# sub 0.01084f
C29 a_784_15# sub 0.01084f
C30 a_670_15# sub 0.01084f
C31 a_556_15# sub 0.01084f
C32 a_442_15# sub 0.01084f
C33 a_328_15# sub 0.01084f
C34 a_214_15# sub 0.01084f
C35 a_100_15# sub 0.01084f
C36 a_74_n21# sub 0.01618f
C37 a_0_0# sub 0.01942f
.ends

.subckt pc_pmos_4 a_68_n36# a_344_0# w_n62_n62# a_244_n36# sub a_520_0# a_420_n36# a_168_0#  a_0_0#
X0 a_520_0# a_420_n36# a_344_0# w_n62_n62# sg13_lv_pmos ad=0.408p pd=3.08u as=0.228p ps=1.58u w=1.2u l=0.5u
X1 a_168_0# a_68_n36# a_0_0# w_n62_n62# sg13_lv_pmos ad=0.228p pd=1.58u as=0.408p ps=3.08u w=1.2u l=0.5u
X2 a_344_0# a_244_n36# a_168_0# w_n62_n62# sg13_lv_pmos ad=0.228p pd=1.58u as=0.228p ps=1.58u w=1.2u l=0.5u
C0 a_344_0# a_520_0# 0.05694f
C1 a_344_0# a_420_n36# 0.02238f
C2 a_0_0# w_n62_n62# 0.01435f
C3 a_0_0# a_168_0# 0.05694f
C4 a_244_n36# w_n62_n62# 0.08651f
C5 a_244_n36# a_168_0# 0.02238f
C6 a_244_n36# a_420_n36# 0.01172f
C7 a_168_0# w_n62_n62# 0.01302f
C8 a_0_0# a_68_n36# 0.02238f
C9 a_344_0# a_244_n36# 0.02238f
C10 w_n62_n62# a_520_0# 0.01435f
C11 a_244_n36# a_68_n36# 0.01172f
C12 a_420_n36# w_n62_n62# 0.08919f
C13 a_344_0# w_n62_n62# 0.01302f
C14 w_n62_n62# a_68_n36# 0.08919f
C15 a_420_n36# a_520_0# 0.02238f
C16 a_344_0# a_168_0# 0.05694f
C17 a_168_0# a_68_n36# 0.02238f
C18 a_520_0# sub 0.05058f
C19 a_344_0# sub 0.01094f
C20 a_168_0# sub 0.01094f
C21 a_0_0# sub 0.05058f
C22 a_420_n36# sub 0.04556f
C23 a_244_n36# sub 0.0382f
C24 a_68_n36# sub 0.04556f
.ends

.subckt pc_nmos_7 a_100_15# a_74_n21# sub a_0_0#
X0 a_100_15# a_74_n21# a_0_0# sub sg13_lv_nmos ad=0.1005p pd=1.34u as=0.1005p ps=1.34u w=0.15u l=0.13u
C0 a_100_15# a_0_0# 0.02238f
C1 a_100_15# sub 0.02279f
C2 a_74_n21# sub 0.04944f
C3 a_0_0# sub 0.02279f
.ends

.subckt pc_rhigh a_0_674# sub a_0_n86# a_0_0#
X0 a_0_674# a_0_n86# sub rhigh l=3.37u w=0.5u
C0 a_0_0# a_0_674# 0.01678f
C1 a_0_0# a_0_n86# 0.01678f
C2 a_0_n86# sub 0.11782f
C3 a_0_0# sub 0.4475f
C4 a_0_674# sub 0.11782f
.ends

.subckt pc_pmos_2 a_68_n36# w_n62_n62# sub a_168_0# a_0_0#
X0 a_168_0# a_68_n36# a_0_0# w_n62_n62# sg13_lv_pmos ad=0.408p pd=3.08u as=0.408p ps=3.08u w=1.2u l=0.5u
C0 a_0_0# w_n62_n62# 0.01435f
C1 a_68_n36# w_n62_n62# 0.09187f
C2 a_168_0# w_n62_n62# 0.01435f
C3 a_68_n36# a_0_0# 0.02238f
C4 a_168_0# a_0_0# 0.05694f
C5 a_168_0# a_68_n36# 0.02238f
C6 a_168_0# sub 0.05058f
C7 a_0_0# sub 0.05058f
C8 a_68_n36# sub 0.05293f
.ends

.subckt pc_nmos_5 a_68_n36# a_344_0# a_244_n36# sub a_520_0# a_596_n36# a_420_n36# a_168_0#  a_0_0# a_696_0#
X0 a_520_0# a_420_n36# a_344_0# sub sg13_lv_nmos ad=0.2964p pd=1.94u as=0.2964p ps=1.94u w=1.56u l=0.5u
X1 a_696_0# a_596_n36# a_520_0# sub sg13_lv_nmos ad=0.5304p pd=3.8u as=0.2964p ps=1.94u w=1.56u l=0.5u
X2 a_168_0# a_68_n36# a_0_0# sub sg13_lv_nmos ad=0.2964p pd=1.94u as=0.5304p ps=3.8u w=1.56u l=0.5u
X3 a_344_0# a_244_n36# a_168_0# sub sg13_lv_nmos ad=0.2964p pd=1.94u as=0.2964p ps=1.94u w=1.56u l=0.5u
C0 a_0_0# a_68_n36# 0.0291f
C1 a_244_n36# a_68_n36# 0.01172f
C2 a_168_0# a_0_0# 0.07402f
C3 a_168_0# a_344_0# 0.07402f
C4 a_168_0# a_244_n36# 0.0291f
C5 a_696_0# a_520_0# 0.07402f
C6 a_696_0# a_596_n36# 0.0291f
C7 a_420_n36# a_344_0# 0.0291f
C8 a_244_n36# a_344_0# 0.0291f
C9 a_244_n36# a_420_n36# 0.01172f
C10 a_344_0# a_520_0# 0.07402f
C11 a_420_n36# a_520_0# 0.0291f
C12 a_596_n36# a_420_n36# 0.01172f
C13 a_596_n36# a_520_0# 0.0291f
C14 a_168_0# a_68_n36# 0.0291f
C15 a_696_0# sub 0.07249f
C16 a_520_0# sub 0.01267f
C17 a_344_0# sub 0.01267f
C18 a_168_0# sub 0.01267f
C19 a_0_0# sub 0.07249f
C20 a_596_n36# sub 0.15049f
C21 a_420_n36# sub 0.14045f
C22 a_244_n36# sub 0.14045f
C23 a_68_n36# sub 0.15049f
.ends

.subckt pc_pmosHV_4 a_68_n36# a_344_0# a_244_n36# w_n124_n124# sub a_520_0# a_596_n36#  a_420_n36# a_168_0# a_0_0# a_696_0#
X0 a_520_0# a_420_n36# a_344_0# w_n124_n124# sg13_hv_pmos ad=0.855p pd=4.88u as=0.855p ps=4.88u w=4.5u l=0.5u
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
.ends

.subckt pc_nmosHV a_68_n36# sub a_468_0# a_0_0#
X0 a_468_0# a_68_n36# a_0_0# sub sg13_hv_nmos ad=0.17p pd=1.68u as=0.17p ps=1.68u w=0.5u l=2u
C0 a_0_0# a_68_n36# 0.0174f
C1 a_468_0# a_68_n36# 0.0174f
C2 a_468_0# sub 0.03184f
C3 a_0_0# sub 0.03184f
C4 a_68_n36# sub 0.3606f
.ends

.subckt pc_nmosHV_1 a_944_0# a_1496_n36# a_1896_0# a_68_n36# sub a_1020_n36# a_468_0#  a_1420_0# a_0_0# a_544_n36#
X0 a_1896_0# a_1496_n36# a_1420_0# sub sg13_hv_nmos ad=0.17p pd=1.68u as=95f ps=0.88u w=0.5u l=2u
X1 a_1420_0# a_1020_n36# a_944_0# sub sg13_hv_nmos ad=95f pd=0.88u as=95f ps=0.88u w=0.5u l=2u
X2 a_944_0# a_544_n36# a_468_0# sub sg13_hv_nmos ad=95f pd=0.88u as=95f ps=0.88u w=0.5u l=2u
X3 a_468_0# a_68_n36# a_0_0# sub sg13_hv_nmos ad=95f pd=0.88u as=0.17p ps=1.68u w=0.5u l=2u
C0 a_1020_n36# a_544_n36# 0.01172f
C1 a_944_0# a_544_n36# 0.0174f
C2 a_944_0# a_1020_n36# 0.0174f
C3 a_544_n36# a_468_0# 0.0174f
C4 a_1020_n36# a_1420_0# 0.0174f
C5 a_1020_n36# a_1496_n36# 0.01172f
C6 a_544_n36# a_68_n36# 0.01172f
C7 a_1496_n36# a_1420_0# 0.0174f
C8 a_1496_n36# a_1896_0# 0.0174f
C9 a_68_n36# a_468_0# 0.0174f
C10 a_68_n36# a_0_0# 0.0174f
C11 a_1896_0# sub 0.03184f
C12 a_1420_0# sub 0.01267f
C13 a_944_0# sub 0.01267f
C14 a_468_0# sub 0.01267f
C15 a_0_0# sub 0.03184f
C16 a_1496_n36# sub 0.35055f
C17 a_1020_n36# sub 0.34051f
C18 a_544_n36# sub 0.34051f
C19 a_68_n36# sub 0.35055f
.ends

.subckt pc_pmos_5 a_100_15# w_n62_n62# a_74_n21# sub a_0_0#
X0 a_100_15# a_74_n21# a_0_0# w_n62_n62# sg13_lv_pmos ad=0.1005p pd=1.34u as=0.1005p ps=1.34u w=0.15u l=0.13u
C0 a_74_n21# w_n62_n62# 0.02613f
C1 a_100_15# a_0_0# 0.02238f
C2 a_100_15# sub 0.01942f
C3 a_74_n21# sub 0.02332f
C4 a_0_0# sub 0.01942f
.ends

.subckt pc_nmos_8 a_100_15# a_328_15# a_188_n21# a_74_n21# sub a_214_15# a_302_n21# a_0_0#
X0 a_328_15# a_302_n21# a_214_15# sub sg13_lv_nmos ad=0.1005p pd=1.34u as=55.5f ps=0.74u w=0.15u l=0.13u
X1 a_100_15# a_74_n21# a_0_0# sub sg13_lv_nmos ad=55.5f pd=0.74u as=0.1005p ps=1.34u w=0.15u l=0.13u
X2 a_214_15# a_188_n21# a_100_15# sub sg13_lv_nmos ad=55.5f pd=0.74u as=55.5f ps=0.74u w=0.15u l=0.13u
C0 a_328_15# a_214_15# 0.02238f
C1 a_100_15# a_0_0# 0.02238f
C2 a_188_n21# a_74_n21# 0.01005f
C3 a_188_n21# a_302_n21# 0.01005f
C4 a_100_15# a_214_15# 0.02238f
C5 a_328_15# sub 0.02279f
C6 a_302_n21# sub 0.0401f
C7 a_214_15# sub 0.01308f
C8 a_188_n21# sub 0.03076f
C9 a_100_15# sub 0.01308f
C10 a_74_n21# sub 0.0401f
C11 a_0_0# sub 0.02279f
.ends

.subckt pc_pmos_3 a_68_n36# a_344_0# w_n62_n62# a_244_n36# sub a_520_0# a_596_n36# a_420_n36#  a_168_0# a_0_0# a_696_0#
X0 a_520_0# a_420_n36# a_344_0# w_n62_n62# sg13_lv_pmos ad=0.228p pd=1.58u as=0.228p ps=1.58u w=1.2u l=0.5u
X1 a_696_0# a_596_n36# a_520_0# w_n62_n62# sg13_lv_pmos ad=0.408p pd=3.08u as=0.228p ps=1.58u w=1.2u l=0.5u
X2 a_168_0# a_68_n36# a_0_0# w_n62_n62# sg13_lv_pmos ad=0.228p pd=1.58u as=0.408p ps=3.08u w=1.2u l=0.5u
X3 a_344_0# a_244_n36# a_168_0# w_n62_n62# sg13_lv_pmos ad=0.228p pd=1.58u as=0.228p ps=1.58u w=1.2u l=0.5u
C0 a_244_n36# a_68_n36# 0.01172f
C1 a_168_0# a_68_n36# 0.02238f
C2 a_168_0# a_244_n36# 0.02238f
C3 a_68_n36# a_0_0# 0.02238f
C4 a_244_n36# a_344_0# 0.02238f
C5 a_244_n36# a_420_n36# 0.01172f
C6 a_168_0# a_0_0# 0.05694f
C7 a_168_0# a_344_0# 0.05694f
C8 a_696_0# a_520_0# 0.05694f
C9 a_68_n36# w_n62_n62# 0.08919f
C10 a_596_n36# a_696_0# 0.02238f
C11 a_420_n36# a_344_0# 0.02238f
C12 a_244_n36# w_n62_n62# 0.08651f
C13 w_n62_n62# a_696_0# 0.01435f
C14 a_344_0# a_520_0# 0.05694f
C15 a_168_0# w_n62_n62# 0.01302f
C16 a_420_n36# a_520_0# 0.02238f
C17 a_596_n36# a_420_n36# 0.01172f
C18 w_n62_n62# a_0_0# 0.01435f
C19 w_n62_n62# a_344_0# 0.01302f
C20 w_n62_n62# a_420_n36# 0.08651f
C21 a_596_n36# a_520_0# 0.02238f
C22 w_n62_n62# a_520_0# 0.01302f
C23 w_n62_n62# a_596_n36# 0.08919f
C24 a_696_0# sub 0.05058f
C25 a_520_0# sub 0.01094f
C26 a_344_0# sub 0.01094f
C27 a_168_0# sub 0.01094f
C28 a_0_0# sub 0.05058f
C29 a_596_n36# sub 0.04556f
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
C19 a_3420_n36# a_5096_n36# 0.01172f
C20 a_6696_0# sub 0.02968f
C21 a_5020_0# sub 0.0154f
C22 a_3344_0# sub 0.0154f
C23 a_1668_0# sub 0.0154f
C24 a_0_0# sub 0.02968f
C25 a_5096_n36# sub 0.61856f
C26 a_3420_n36# sub 0.61119f
C27 a_1744_n36# sub 0.61119f
C28 a_68_n36# sub 0.61856f
.ends

.subckt pc_pmos_1 a_68_n36# w_n62_n62# sub a_1744_n36# a_3344_0# a_0_0# a_1668_0#
X0 a_3344_0# a_1744_n36# a_1668_0# w_n62_n62# sg13_lv_pmos ad=0.17p pd=1.68u as=95f ps=0.88u w=0.5u l=8u
X1 a_1668_0# a_68_n36# a_0_0# w_n62_n62# sg13_lv_pmos ad=95f pd=0.88u as=0.17p ps=1.68u w=0.5u l=8u
C0 a_1744_n36# a_68_n36# 0.01172f
C1 a_68_n36# a_0_0# 0.02075f
C2 a_1744_n36# a_3344_0# 0.02075f
C3 a_68_n36# a_1668_0# 0.02075f
C4 a_68_n36# w_n62_n62# 0.71759f
C5 a_1744_n36# a_1668_0# 0.02075f
C6 a_1744_n36# w_n62_n62# 0.71759f
C7 w_n62_n62# a_3344_0# 0.0102f
C8 w_n62_n62# a_0_0# 0.0102f
C9 w_n62_n62# a_1668_0# 0.01297f
C10 a_3344_0# sub 0.02968f
C11 a_1668_0# sub 0.0154f
C12 a_0_0# sub 0.02968f
C13 a_1744_n36# sub 0.61856f
C14 a_68_n36# sub 0.61856f
.ends

.subckt pc_nmos_4 a_68_n36# sub a_168_0# a_0_0#
X0 a_168_0# a_68_n36# a_0_0# sub sg13_lv_nmos ad=0.5304p pd=3.8u as=0.5304p ps=3.8u w=1.56u l=0.5u
C0 a_168_0# a_0_0# 0.07402f
C1 a_0_0# a_68_n36# 0.0291f
C2 a_168_0# a_68_n36# 0.0291f
C3 a_168_0# sub 0.07249f
C4 a_0_0# sub 0.07249f
C5 a_68_n36# sub 0.16054f
.ends

.subckt pc_pmosHV_3 a_268_0# a_896_n36# a_68_n36# a_344_n36# a_620_n36# w_n124_n124#  sub a_820_0# a_1096_0# a_544_0# a_0_0#
X0 a_1096_0# a_896_n36# a_820_0# w_n124_n124# sg13_hv_pmos ad=0.17p pd=1.68u as=95f ps=0.88u w=0.5u l=1u
X1 a_268_0# a_68_n36# a_0_0# w_n124_n124# sg13_hv_pmos ad=95f pd=0.88u as=0.17p ps=1.68u w=0.5u l=1u
X2 a_820_0# a_620_n36# a_544_0# w_n124_n124# sg13_hv_pmos ad=95f pd=0.88u as=95f ps=0.88u w=0.5u l=1u
X3 a_544_0# a_344_n36# a_268_0# w_n124_n124# sg13_hv_pmos ad=95f pd=0.88u as=95f ps=0.88u w=0.5u l=1u
C0 a_344_n36# a_68_n36# 0.01172f
C1 a_268_0# a_68_n36# 0.01382f
C2 a_268_0# a_344_n36# 0.01382f
C3 a_68_n36# a_0_0# 0.01382f
C4 a_344_n36# a_544_0# 0.01382f
C5 a_344_n36# a_620_n36# 0.01172f
C6 a_268_0# a_0_0# 0.01358f
C7 a_268_0# a_544_0# 0.01358f
C8 a_1096_0# a_820_0# 0.01358f
C9 a_68_n36# w_n124_n124# 0.12891f
C10 a_896_n36# a_1096_0# 0.01382f
C11 a_620_n36# a_544_0# 0.01382f
C12 a_344_n36# w_n124_n124# 0.12435f
C13 w_n124_n124# a_1096_0# 0.01141f
C14 a_544_0# a_820_0# 0.01358f
C15 a_620_n36# a_820_0# 0.01382f
C16 a_896_n36# a_620_n36# 0.01172f
C17 w_n124_n124# a_0_0# 0.01141f
C18 w_n124_n124# a_620_n36# 0.12435f
C19 a_896_n36# a_820_0# 0.01382f
C20 w_n124_n124# a_896_n36# 0.12891f
C21 a_1096_0# sub 0.02349f
C22 a_0_0# sub 0.02349f
C23 a_896_n36# sub 0.05737f
C24 a_620_n36# sub 0.05189f
C25 a_344_n36# sub 0.05189f
C26 a_68_n36# sub 0.05737f
.ends

.subckt pc_pmosHV a_68_n36# w_n124_n124# sub a_218_0# a_0_0#
X0 a_218_0# a_68_n36# a_0_0# w_n124_n124# sg13_hv_pmos ad=0.17p pd=1.68u as=0.17p ps=1.68u w=0.5u l=0.75u
C0 a_0_0# w_n124_n124# 0.01096f
C1 a_218_0# a_68_n36# 0.01199f
C2 a_218_0# w_n124_n124# 0.01096f
C3 a_68_n36# w_n124_n124# 0.10538f
C4 a_218_0# a_0_0# 0.01734f
C5 a_0_0# a_68_n36# 0.01199f
C6 a_218_0# sub 0.02349f
C7 a_0_0# sub 0.02349f
C8 a_68_n36# sub 0.04988f
.ends

.subckt pc_nmos_2 a_68_n36# a_3420_n36# sub a_5020_0# a_1744_n36# a_3344_0# a_0_0# a_1668_0#
X0 a_3344_0# a_1744_n36# a_1668_0# sub sg13_lv_nmos ad=95f pd=0.88u as=95f ps=0.88u w=0.5u l=8u
X1 a_5020_0# a_3420_n36# a_3344_0# sub sg13_lv_nmos ad=0.17p pd=1.68u as=95f ps=0.88u w=0.5u l=8u
X2 a_1668_0# a_68_n36# a_0_0# sub sg13_lv_nmos ad=95f pd=0.88u as=0.17p ps=1.68u w=0.5u l=8u
C0 a_1744_n36# a_1668_0# 0.02075f
C1 a_3420_n36# a_3344_0# 0.02075f
C2 a_68_n36# a_1668_0# 0.02075f
C3 a_1744_n36# a_3344_0# 0.02075f
C4 a_0_0# a_68_n36# 0.02075f
C5 a_1744_n36# a_68_n36# 0.01172f
C6 a_3420_n36# a_1744_n36# 0.01172f
C7 a_5020_0# a_3420_n36# 0.02075f
C8 a_5020_0# sub 0.03407f
C9 a_3344_0# sub 0.01712f
C10 a_1668_0# sub 0.01712f
C11 a_0_0# sub 0.03407f
C12 a_3420_n36# sub 1.33615f
C13 a_1744_n36# sub 1.3261f
C14 a_68_n36# sub 1.33615f
.ends

.subckt pc_nmosHV_4 a_268_0# a_896_n36# a_68_n36# a_344_n36# a_620_n36# sub a_820_0#  a_1096_0# a_544_0# a_0_0#
X0 a_820_0# a_620_n36# a_544_0# sub sg13_hv_nmos ad=0.437p pd=2.68u as=0.437p ps=2.68u w=2.3u l=1u
X1 a_544_0# a_344_n36# a_268_0# sub sg13_hv_nmos ad=0.437p pd=2.68u as=0.437p ps=2.68u w=2.3u l=1u
X2 a_1096_0# a_896_n36# a_820_0# sub sg13_hv_nmos ad=0.782p pd=5.28u as=0.437p ps=2.68u w=2.3u l=1u
X3 a_268_0# a_68_n36# a_0_0# sub sg13_hv_nmos ad=0.437p pd=2.68u as=0.782p ps=5.28u w=2.3u l=1u
C0 a_620_n36# a_344_n36# 0.01172f
C1 a_544_0# a_344_n36# 0.06358f
C2 a_544_0# a_620_n36# 0.06358f
C3 a_344_n36# a_268_0# 0.06358f
C4 a_620_n36# a_820_0# 0.06358f
C5 a_620_n36# a_896_n36# 0.01172f
C6 a_544_0# a_268_0# 0.06246f
C7 a_544_0# a_820_0# 0.06246f
C8 a_344_n36# a_68_n36# 0.01172f
C9 a_896_n36# a_820_0# 0.06358f
C10 a_820_0# a_1096_0# 0.06246f
C11 a_896_n36# a_1096_0# 0.06358f
C12 a_0_0# a_268_0# 0.06246f
C13 a_68_n36# a_268_0# 0.06358f
C14 a_68_n36# a_0_0# 0.06358f
C15 a_1096_0# sub 0.10087f
C16 a_820_0# sub 0.01267f
C17 a_544_0# sub 0.01267f
C18 a_268_0# sub 0.01267f
C19 a_0_0# sub 0.10087f
C20 a_896_n36# sub 0.34367f
C21 a_620_n36# sub 0.33362f
C22 a_344_n36# sub 0.33362f
C23 a_68_n36# sub 0.34367f
.ends

.subckt pc_pmosHV_1 a_68_n36# w_n124_n124# sub a_444_0# a_294_n36# a_218_0# a_0_0#
X0 a_218_0# a_68_n36# a_0_0# w_n124_n124# sg13_hv_pmos ad=95f pd=0.88u as=0.17p ps=1.68u w=0.5u l=0.75u
X1 a_444_0# a_294_n36# a_218_0# w_n124_n124# sg13_hv_pmos ad=0.17p pd=1.68u as=95f ps=0.88u w=0.5u l=0.75u
C0 a_68_n36# a_218_0# 0.01199f
C1 a_294_n36# a_444_0# 0.01199f
C2 a_294_n36# w_n124_n124# 0.10082f
C3 a_0_0# a_68_n36# 0.01199f
C4 a_444_0# a_218_0# 0.01734f
C5 a_0_0# w_n124_n124# 0.01096f
C6 a_68_n36# w_n124_n124# 0.10082f
C7 a_444_0# w_n124_n124# 0.01096f
C8 a_294_n36# a_218_0# 0.01199f
C9 a_294_n36# a_68_n36# 0.01172f
C10 a_0_0# a_218_0# 0.01734f
C11 a_444_0# sub 0.02349f
C12 a_0_0# sub 0.02349f
C13 a_294_n36# sub 0.0444f
C14 a_68_n36# sub 0.0444f
.ends
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
