chennakeshavadasa/PVT-Invariant-Ring-Amplifier/(commit log)

2026-09-09 Revise README for clarity and additional details
    Updated README with detailed project background, specifications, and schematics.
2026-10-16 Make xschem schematics portable
    Replace the absolute /foss/designs/... symbol paths (IIC-OSIC-TOOLS
    container) with paths relative to Design Files/RAMP, map the local
    fd_pr device copies to the PDK's sg13g2_pr symbols, and add a project
    xschemrc that loads the IHP SG13G2 setup and this library directory.
2026-10-16 Add layout-ready ring amplifier (RAMP_LR) schematics
    The original schematics use ideal current sources, an ideal CMFB amplifier
    (E1, gain 10k, no pole) and ideal resistors, which cannot be laid out, and
    two loops that are not stable in transient (E1's CMFB loop and the deadzone
    regulation loops, PM -27 deg / 11 deg). RAMP_LR keeps the topology and
    sizes but is built from PDK devices only:
    - one external IBIAS (1 uA) mirrored by 0.5/8 um units (<= 4 % error)
    - transistor CMFB (MC1/MC2, diode loads mirrored into the stage-1 loads)
    - rhigh resistors, 2 pF MIM decoupling on VCTRLP/VCTRLN
    - body of the three body-to-source NMOS tied to GND (p-substrate)
    - matching dummies collected in DUMMY_LR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
2026-10-16 Add matched SG13G2 layout of RAMP_LR, DRC and LVS clean
    layout/gen_layout.py builds the layout from layout/ramp_lr_design.py with
    IHP PCells: one row of unit transistors per matching group, common-centroid
    input/CMFB pairs and OTA pairs (ABBA), interdigitated bias mirrors (3x9
    common-centroid array around the reference), replica references centred in
    the output-stage arrays, dummies at every row end, same orientation for all
    units, continuous substrate/well ties per row, rhigh halves in common
    centroid, and the 2 pF MIM capacitors on Metal5/TopMetal1 above the routing.
    - DRC (IHP KLayout main deck incl. extra rules, no density): 0 violations
    - antenna: 0 (MOS gate caps on VCTRLP/VCTRLN for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
2026-10-16 Add PVT simulation harness and results for RAMP_LR
    sim/ramp_pvt.py netlists the xschem testbenches and runs, for the
    regulated design, a fixed-bias twin (VCTRLP/VCTRLN frozen at TT/27 C)
    and a PTAT-reference variant: operating point, Middlebrook loop gain,
    PSRR, a unity-gain-buffer step and a switched-capacitor (charge transfer,
    CS/CF = 1, CL = 50 pF) large/small step, over 5 corners x -40/27/125 C x
    VDD +-5 %, plus DC temperature sweeps and a supply-current breakdown.
    Settling is measured against the true final value, so a response that
    stops inside the deadzone counts as an error.
2026-10-16 Add IEEE-style result figures and switched-capacitor step test
    make_figures.py plots loop gain (original vs layout-ready), I_Q and the
    regulated control voltages over temperature, UGF/PM and settling error
    over PVT (fixed bias vs regulation vs PTAT reference), large/small SC
    step responses, the three settling phases (PNG + GIF), the supply
    current breakdown and PSRR. The SC test now applies the small steps
    first, from a settled state.
2026-10-16 Two-column matched floor plan, 6x5 bias array, segmented resistors
    The rows are now grouped in bands of a left and a right row that share
    their gate and source/drain channels, with the Metal3 spine between the
    columns: 109 x 183 um instead of 121 x 211 um and far less empty area.
    The NMOS bias mirror is a 6 x 5 point-symmetric common-centroid array,
    the PMOS mirror a 2 x 3 array, and each 100 kOhm rhigh is four series
    segments in an ABBAABBA pattern. run_checks.sh regenerates the layout
    and writes DRC/antenna/density/LVS reports to layout/reports/:
    DRC clean, antenna clean, LVS match (53 devices, 33 nets).
2026-10-16 Rewrite README as a report; add diagrams, schematic exports and audit
    The README is now an IEEE-style report: abstract, reproduction steps,
    introduction, background and prior art with figures reproduced from the
    dissertation, the IHP SG13G2 implementation, the stability analysis of
    the internal loops, the layout-ready redesign, PVT results, layout and
    physical verification, a comparison with prior art, limitations and
    verified references. Also: architecture diagram (docs/make_diagrams.py),
    light-background schematic exports, the internal-loop and CMFB scripts
    behind Tables II and VI, and docs/audit_readme.py, which checks paths,
    figure/table numbering and references.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
2026-10-17 Cross-corner Bode and step-response figures (README Section V-E)
    Loop gain (magnitude and phase) and SC step responses (4 mV and 200 mV,
    output and log settling error) for all five process corners at -40, 27
    and 125 C, fixed bias versus deadzone regulation. ramp_pvt.py now keeps
    the loop-gain and SC waveforms of every corner/temperature; SC files are
    written with 9 digits (6 digits quantised the 4-mV step at 0.025 %).
    Figures 19-22 of the previous README become 22-25.
2026-10-17 Fig. 23: one distinct colour per block in the power donut
2026-10-17 Post-layout (magic PEX) and three-phase-over-corners results
    - gen_layout.py labels the named internal nets (text only; XOR shows no
    geometry change; DRC, antenna clean and LVS match re-checked)
    - layout/run_pex.sh: magic C extraction + netgen LVS (match)
    - sim/postlayout.py: schematic vs post-layout over 5 corners x 3
    temperatures and a per-net parasitic sensitivity run
    - three-phase settling at every corner (fixed vs regulated)
2026-10-17 ngspice: one thread per job; Monte Carlo script
    Parallel jobs each started ngspice with OpenMP on all cores, which
    oversubscribed the machine (about 3x the CPU time per run). A .spiceinit
    with 'set num_threads=1' is now written next to every deck.
    sim/montecarlo.py: process, mismatch and combined Monte Carlo with the
    IHP statistical models, one seeded ngspice process per sample.
2026-10-17 README: three-phase settling over corners, post-layout section, no summary block on top
    - report starts with title and abstract (summary figure/table removed)
    - Section V-E: three-phase settling at every corner (Figs. 22, 23)
    - Section VI-D: schematic vs. post-layout (Table VIII, Figs. 28-31),
    per-net parasitic sensitivity, layout fixes needed
    - abstract, conclusion, limitations, reproduce steps, references
    (magic, netgen) updated
2026-10-17 Fig. 12: redrawn to paper standard
    9-pt text throughout, boxes sized to their text, panel labels (a)-(c),
    regulation-loop equation inside its panel, stage-2 control labels clear
    of the wires, POTA inputs as in the netlist (replica on +, MN_R on -).
2026-10-17 Compact layout: 83.1 x 44.0 um (0.0037 mm2, 5.4x smaller)
    New generator: multi-finger PCells with shared source/drain diffusion
    (ABBA pairs, output devices next to their replicas, stage-2 chains),
    mirrored rows sharing routing channels, constrained left-edge track
    assignment, Metal3 only where a net changes channel, the two 2-pF MIMs
    over the circuit, rows in signal-flow order. Same netlist and sizes;
    rhigh split into 10 x 3.37 um segments per resistor.
    DRC (main deck) and antenna clean, LVS match (53 devices, 33 nets).
2026-10-17 Fig. 12: journal-style transistor-level schematic
    Black line art: stage 2 drawn as its two current-starved inverter stacks
    with the deadzone devices, output stage, trip-point replica, stage-2
    replicas, MP_R/MN_R reference diodes on their 1-uA currents, NOTA/POTA
    and the 2-pF decoupling capacitors; sub-figure labels below the panels.
2026-10-17 Post-layout and Monte Carlo results for the compact layout; README updated
    - magic PEX of the compact layout (913 caps, 0.52 pF; netgen LVS match);
    run_pex.sh joins continuation lines before renaming the cells
    - postlayout.py: ammeter on the four MP3 fingers inside the extracted
    cell (shared diffusion with MP_R and dummies)
    - schematic vs post-layout: PM 61.6 -> 44.4 deg at TT (34.2 deg with the
    first layout), 16 deg at SS -40 C; no plus/Vout coupling any more
    - Monte Carlo (3 sets x 2 biases x 500 samples): regulation removes global
    process variation (I_Q 4.18-4.26 uA) but not local mismatch
    - README: Section VI rewritten for the compact layout, new Section V-F
    (Monte Carlo, Table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
2026-10-17 Fig. 12: stage-2 group box encloses the control-voltage labels
2026-10-17 Figures: no legend or label on the data; new three-phase animation; oscillation analysis
    - every legend moved above or below the axes (Figs. 13, 14, 16, 17, 22, 24, 26);
    panel labels moved to empty corners (Figs. 13, 14, 19, 20-22, 31)
    - three_phase.gif rebuilt: traced waveforms shaded by phase, live output-stage
    view with device currents and the current into C_L, phase explanation;
    1152 x 648 px, 1.9 MB
    - README VI-D: why the post-layout buffer oscillates at SS -40 C (16 deg PM,
    4.8 dB GM, 43-MHz limit cycle for steps >= 10 mV; Vo_STG1 parasitics are
    the cause)
2026-10-17 Animation shows V_GP/V_GN; redesign study scripts and notes
    - three_phase.gif: live gate voltages at MP3/MN3; Fig. 4 caption updated
    - sim/montecarlo.py: sample count parsed in main() (importable)
    - sim/redesign/: stage-by-stage loop analysis, mismatch attribution per
    device group, parametric v2 netlist and grid runner, notes on the
    causes of the oscillation, offset and I_Q spread and the v2 direction
2026-10-17 Redesign: frozen v2 (slow nA integrators on hv devices, larger input pair, MN3 L=1um), verification scripts
2026-10-17 RAMP_V2: design file, generated xschem schematics, PVT characterisation flow
2026-10-17 RAMP_V2 layout (92 x 68 um, DRC/antenna clean, LVS match) and schematic PVT results at +-5 % supply
2026-10-17 RAMP_V2 parasitic extraction (2238 C, 0.69 pF, netgen match), post-layout and Monte Carlo flows
2026-10-17 RAMP_V2 figures (architecture, PVT, settling, limit cycle, start-up, power, layout), figure scripts
2026-10-18 Revert RAMP_V2 redesign: back to the RAMP_LR layout, schematics and verification
    Reverts 0e919e4..6d0e3b6 (RAMP_V2 design file and xschem schematics, layout,
    PEX, post-layout/Monte Carlo flows, figures and the README rewrite). The tree
    is identical to a173dfe: compact RAMP_LR layout (83.1 x 44.0 um, DRC clean,
    LVS match), post-layout and Monte Carlo results, and the v1 README.
